linuxha/A1Video/README.md

# A1Video

An Apple I TTL updated video terminal section.

Modern TTL compatible Video Terminal for the Apple I reproduction boards
