linuxha/A1Video/docs/apple1-man-Pg14-video.pdf

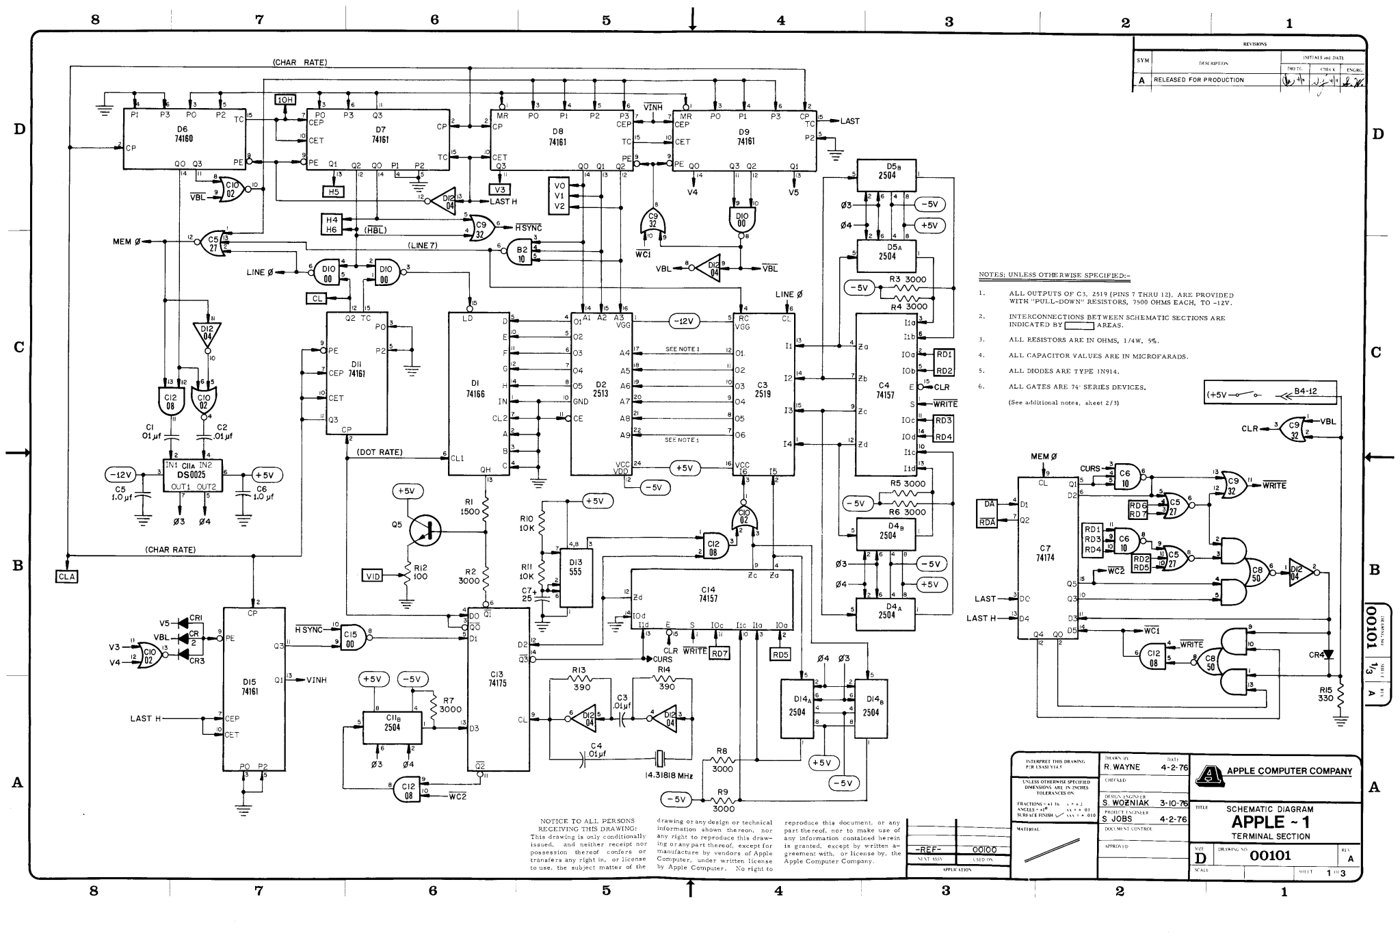
[picture p1: page 1]

8 | 7

(CHAR RATE)

6 | 5 | 4 | 3 | 2 | 1

SYM

IECKENGRE
RELEAS | RODUCTION
13 | 10H | 3 | VINH | 3
P1 | P2 | PO | P3 | Q3 | MR | PO | Pt | P2 | P3 | M | PO | P1 | P3 | CP | LAST D | D7 | D8 74160 | CET | 74161 | 74161 | 74161 | P2

CP
CET | PE PE Q1 | 02 20 P1 | EQO | Q3 Q2 | 2058
VBL | 02 | H5

H4
(HBL)
MEM | C513 | (LINE 7)

V3
LAST

4CS -HSYNC 32

WCI

VBL

V4 | V5
19 | 03- | -5V
1DIO | 04 | +5V

26
D5A 2504

VBL LINE Ø
00

CL

NOTES: | HERWIS R3 3000 -5V LINE Ø | ALL OUTPUTS OF C3, 2519 (PINS 7 THRU 12), ARE PROVIDED
4 | R3000
-12V | RC | 103 | ONS BETWEEN SCHEM

Iib
C | OPE

CEP 7411

13 | DI | D2
C12 | 02 CIO | CET | GN
IOd | RD1

RD2

C3 | CLR 74157

-WRIT

(DOT RATE) | CL
(-12V) | DS0025 | +5V
| ou
| | 1.0

(CHAR RATE)
B
CLA

A

2
CRI
H SYNC-VBL.

V4-

LAST H

ET

+5V
RI
1500
Q5 | RIO 10K

-5V

(+5V

B4-12

322

+5V | VCC

MEMØ
CURS

R5 3000
(-5V
R6 3000
RDA D4B 2504

WRITE

27

RD1

74174 03- -5V RDS

+5V
LASTDC
2504A | LAST H

054 2

WRITE RD7 | RD5 | Ø3

WC1
WRITE
CI2
RI2 | RII | D13
VID | 10K 3000
C7 | C14

DI5
74161
Q1 | VINH | +5V | (-5v | R13
74175 | 390 | 39

C3
3000
2504
03 | 04
C12 08 | -WC2
D14 | DI4
2504
+5V 3000 14.31818 MHz | (-5

R9

3000

conditionally
or

or any design or ther

this draw-
ot for | d, exc

Apple Computer Com

8 | 7
6 | 5 | | 4
-REF- | 00100

APPLICATION

3

D

50

CR4

### RIS

30

C

B00101 1/3 A

R.WAYNE | 4-2-7 | A APPLE COMPUTER COMPANY
CHES | A

010

S. WOZNIAK 3-10-7

PROIECT F

SCHEMATIC DIAGRAM

## APPLE~1

TERMINAL SECTION
D | 00101

2
