linuxha/A1Video/docs/a1video-schematic.png

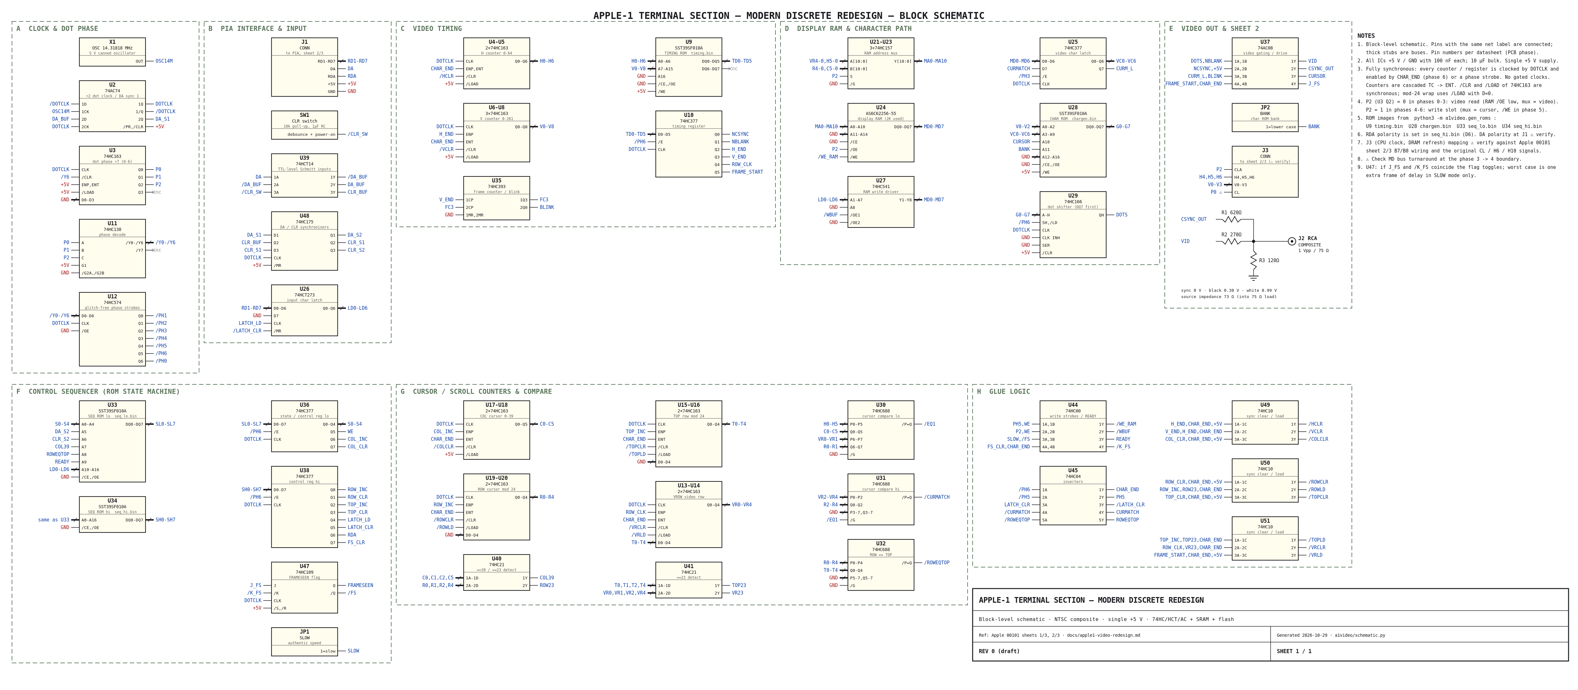
docs/a1video-schematic.png
