linuxha/A1Video/docs/schematic/a1video-sheet1.png

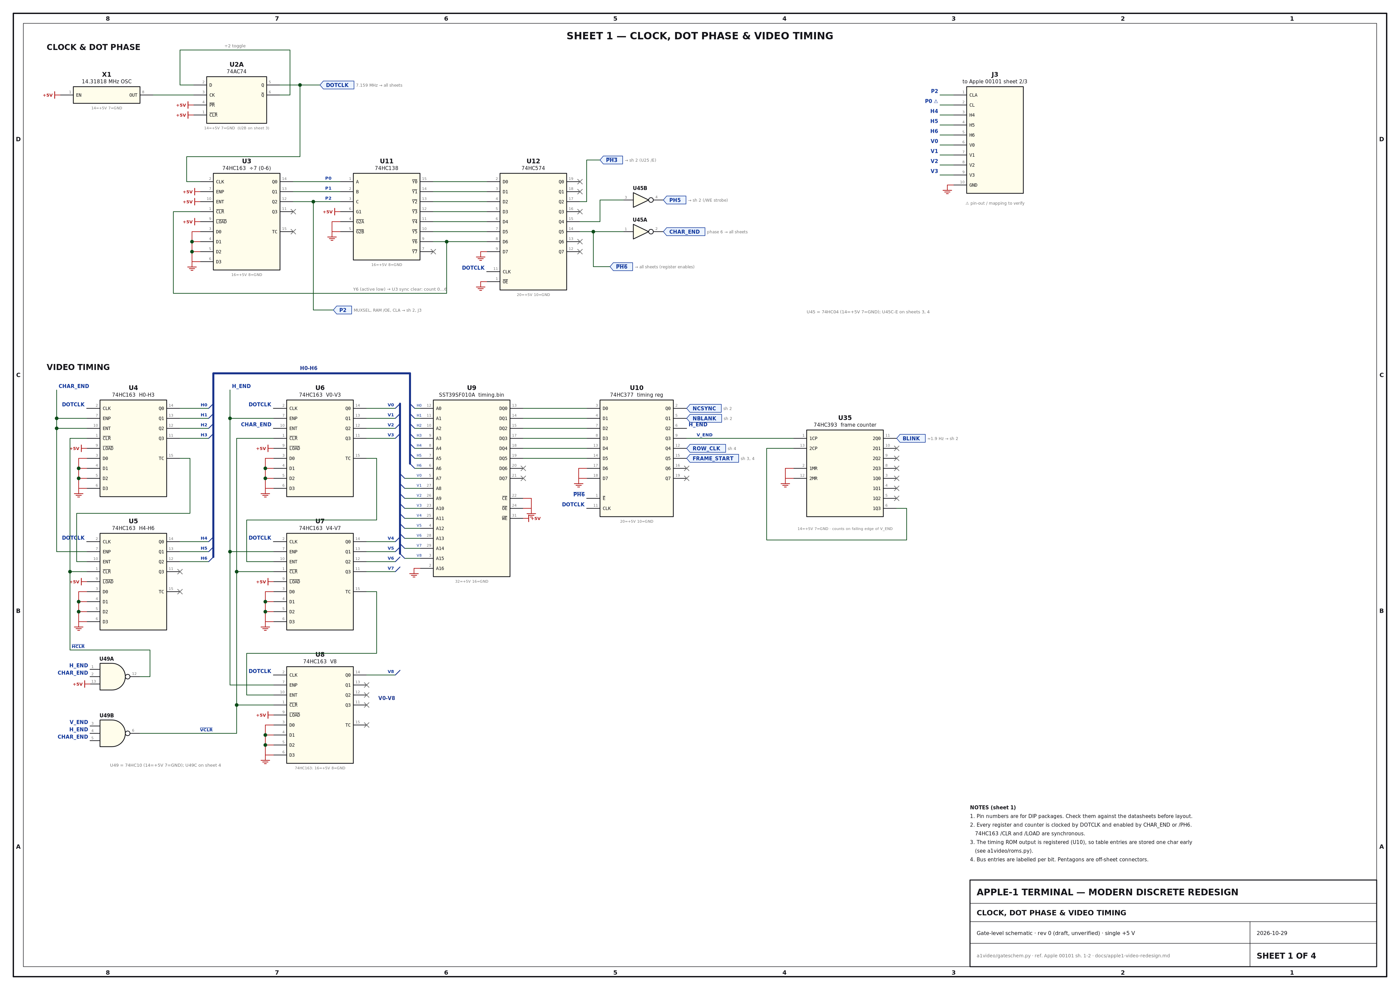
docs/schematic/a1video-sheet1.png
