linuxha/A1Video/docs/schematic/a1video-sheet2.png

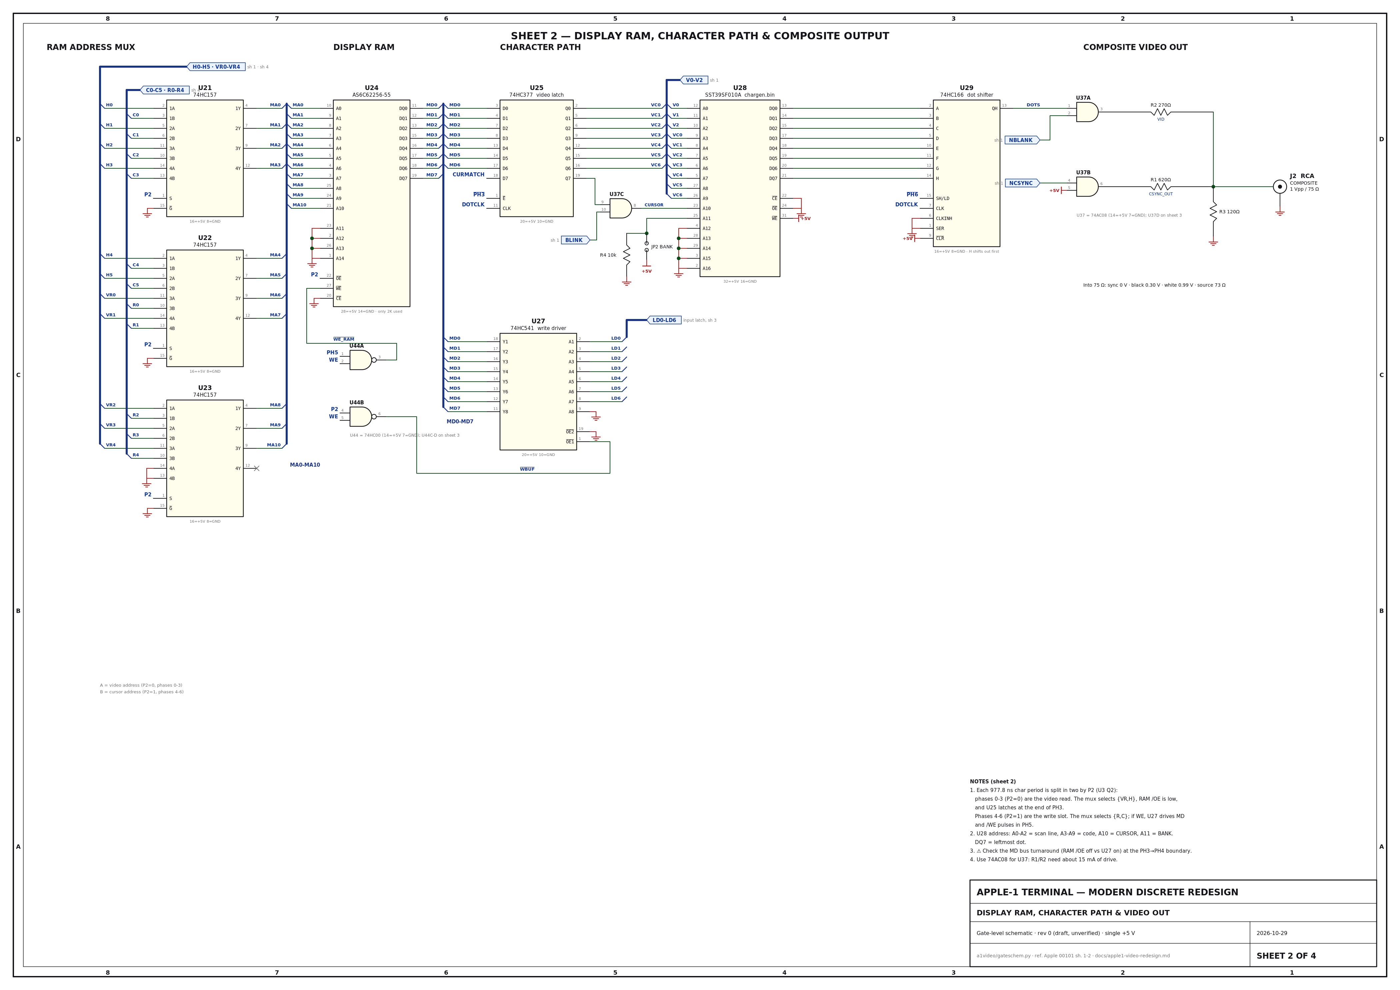
docs/schematic/a1video-sheet2.png
