linuxha/A1Video/docs/schematic/a1video-sheet3.png

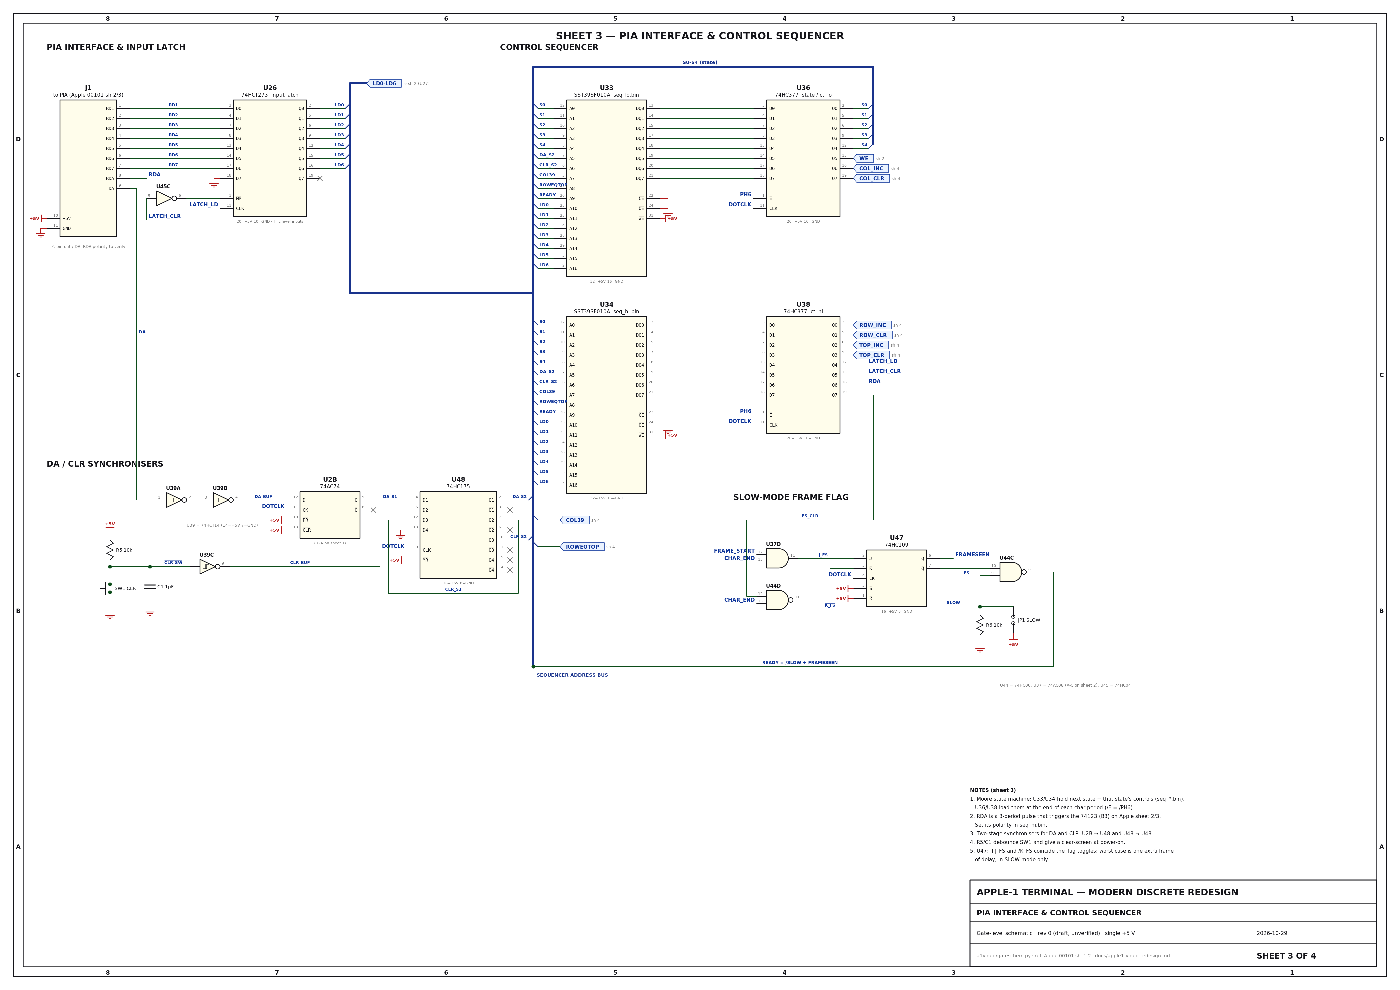
docs/schematic/a1video-sheet3.png
