linuxha/A1Video/docs/schematic/a1video-sheet4.png

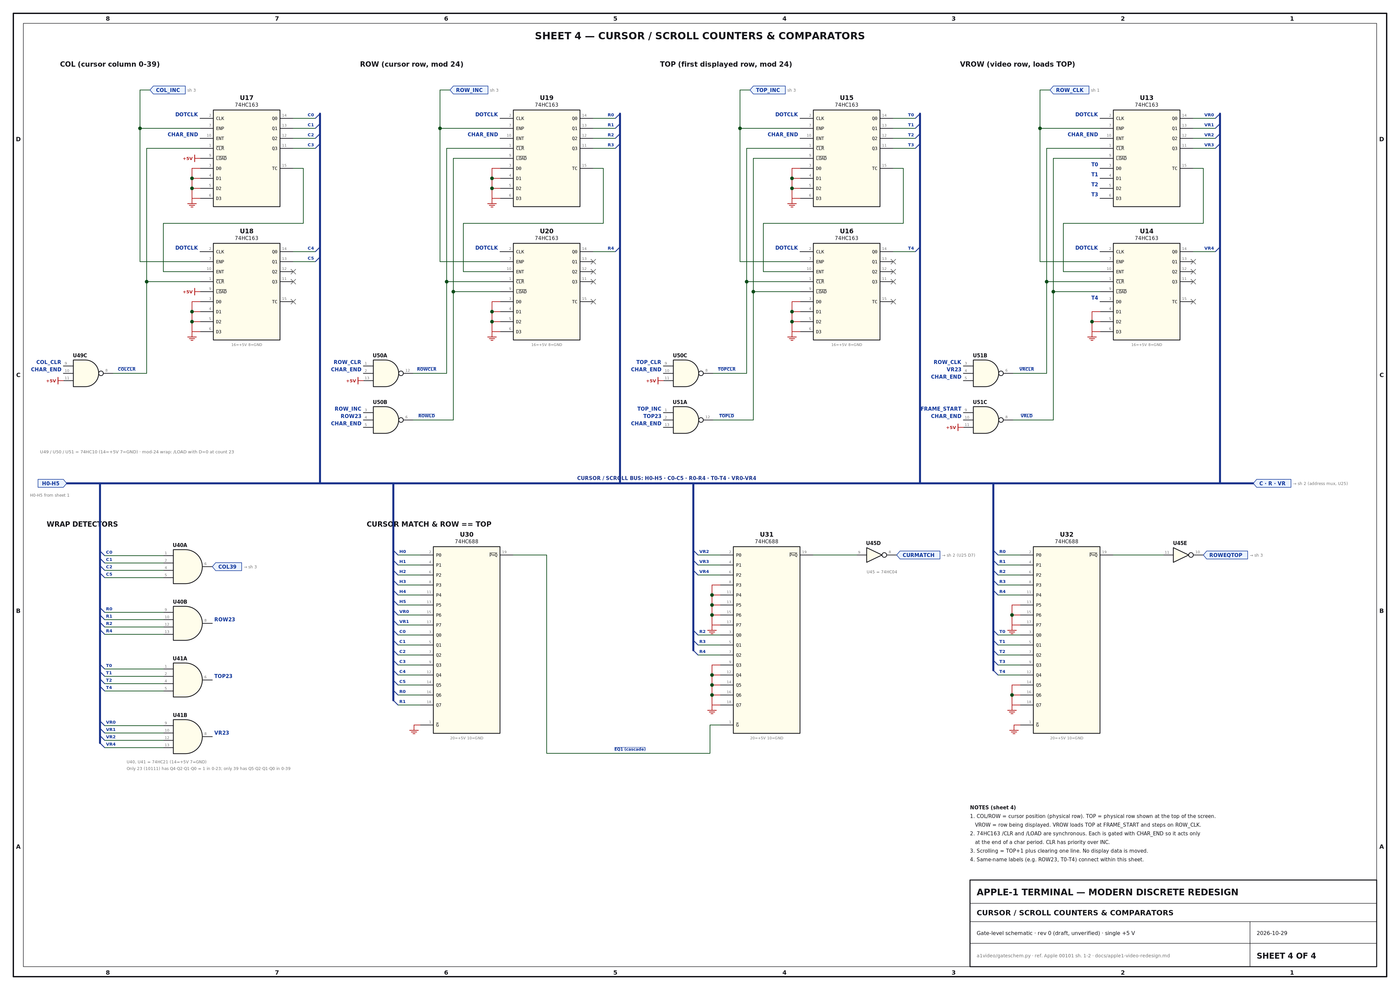
docs/schematic/a1video-sheet4.png
