linuxha/A1Video/kicad/counters.kicad_sch

## KiCad design kicad/counters.kicad_sch (2026-10-29)

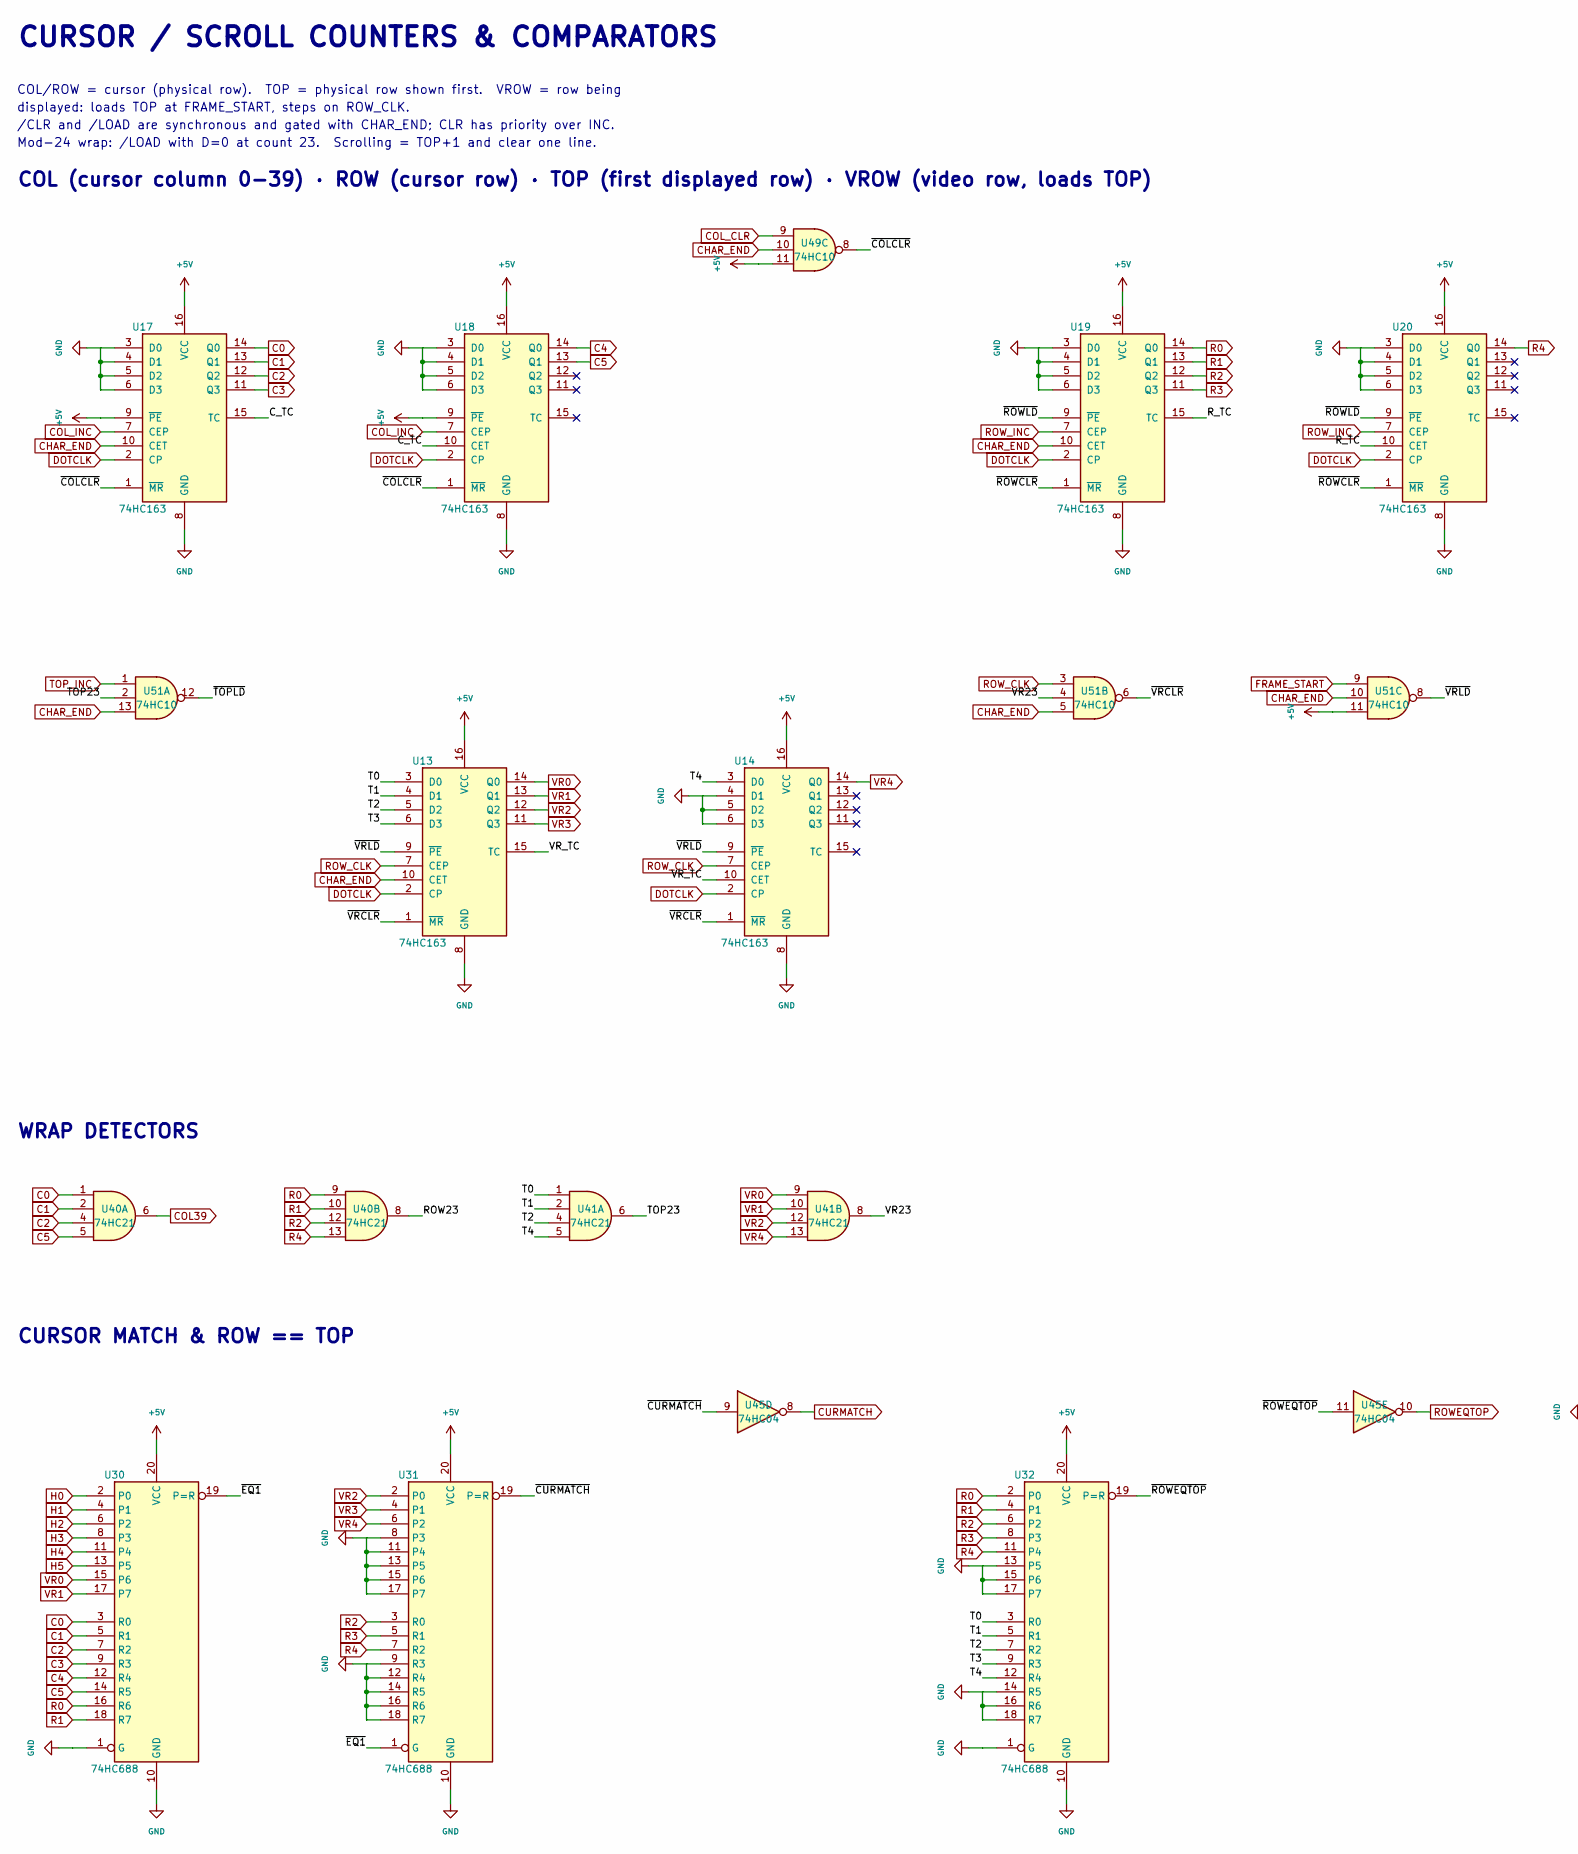
[picture p7: schematic counters.kicad_sch, part in row 1, column 1]

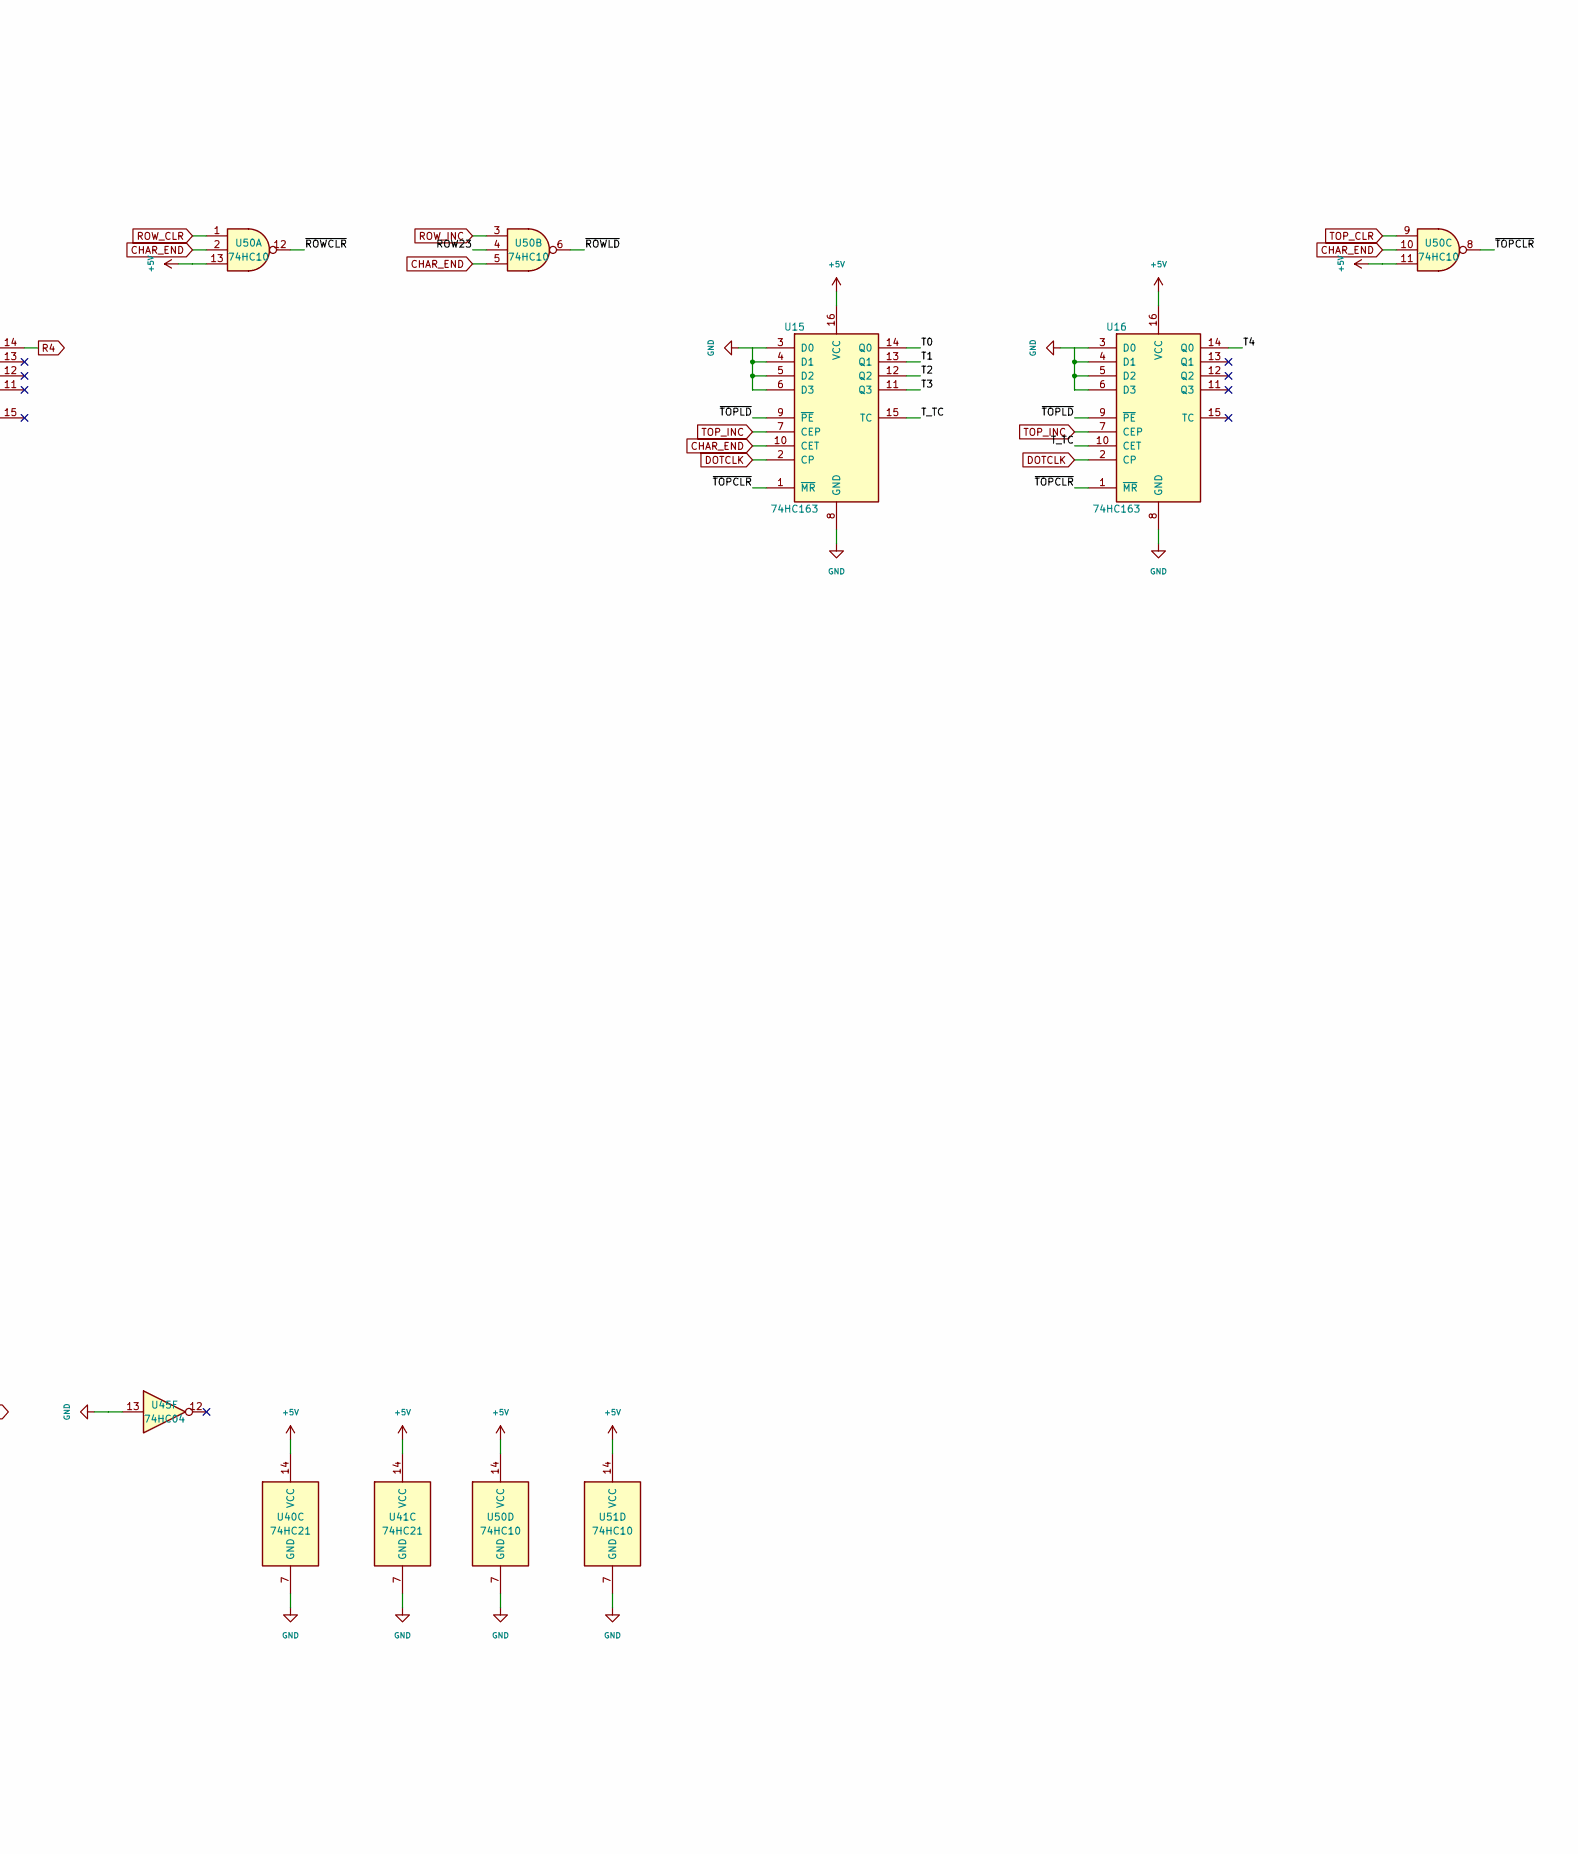
[picture p8: schematic counters.kicad_sch, part in row 1, column 2]

Parts:
U13, U14, U15, U16, U17, U18, U19, U20: 74HC163; DIP-16_W7.62mm
U30, U31, U32: 74HC688; DIP-20_W7.62mm
U40, U41: 74HC21; DIP-14_W7.62mm
U45: 74HC04; DIP-14_W7.62mm
U49, U50, U51: 74HC10; DIP-14_W7.62mm

Connections:
+5V: U13.16 (VCC), U14.16 (VCC), U15.16 (VCC), U16.16 (VCC), U17.9 (~PE), U17.16 (VCC), U18.9 (~PE), U18.16 (VCC), U19.16 (VCC), U20.16 (VCC), U30.20 (VCC), U31.20 (VCC), U32.20 (VCC), U40.14 (VCC), U41.14 (VCC), U49.11, U50.11, U50.13, U50.14 (VCC), U51.11, U51.14 (VCC)
C0: U17.14 (Q0), U30.3 (R0), U40.1
C1: U17.13 (Q1), U30.5 (R1), U40.2
C2: U17.12 (Q2), U30.7 (R2), U40.4
C3: U17.11 (Q3), U30.9 (R3)
C4: U18.14 (Q0), U30.12 (R4)
C5: U18.13 (Q1), U30.14 (R5), U40.5
CHAR_END: U13.10 (CET), U15.10 (CET), U17.10 (CET), U19.10 (CET), U49.10, U50.2, U50.5, U50.10, U51.5, U51.10, U51.13
COL39: U40.6
COL_CLR: U49.9
COL_INC: U17.7 (CEP), U18.7 (CEP)
CURMATCH: U45.8
C_TC: U17.15 (TC), U18.10 (CET)
DOTCLK: U13.2 (CP), U14.2 (CP), U15.2 (CP), U16.2 (CP), U17.2 (CP), U18.2 (CP), U19.2 (CP), U20.2 (CP)
FRAME_START: U51.9
GND: U13.8 (GND), U14.4 (D1), U14.5 (D2), U14.6 (D3), U14.8 (GND), U15.3 (D0), U15.4 (D1), U15.5 (D2), U15.6 (D3), U15.8 (GND), U16.3 (D0), U16.4 (D1), U16.5 (D2), U16.6 (D3), U16.8 (GND), U17.3 (D0), U17.4 (D1), U17.5 (D2), U17.6 (D3), U17.8 (GND), U18.3 (D0), U18.4 (D1), U18.5 (D2), U18.6 (D3), U18.8 (GND), U19.3 (D0), U19.4 (D1), U19.5 (D2), U19.6 (D3), U19.8 (GND), U20.3 (D0), U20.4 (D1), U20.5 (D2), U20.6 (D3), U20.8 (GND), U30.1 (G), U30.10 (GND), U31.8 (P3), U31.9 (R3), U31.10 (GND), U31.11 (P4), U31.12 (R4), U31.13 (P5), U31.14 (R5), U31.15 (P6), U31.16 (R6), U31.17 (P7), U31.18 (R7), U32.1 (G), U32.10 (GND), U32.13 (P5), U32.14 (R5), U32.15 (P6), U32.16 (R6), U32.17 (P7), U32.18 (R7), U40.7 (GND), U41.7 (GND), U45.13, U50.7 (GND), U51.7 (GND)
H0: U30.2 (P0)
H1: U30.4 (P1)
H2: U30.6 (P2)
H3: U30.8 (P3)
H4: U30.11 (P4)
H5: U30.13 (P5)
R0: U19.14 (Q0), U30.16 (R6), U32.2 (P0), U40.9
R1: U19.13 (Q1), U30.18 (R7), U32.4 (P1), U40.10
R2: U19.12 (Q2), U31.3 (R0), U32.6 (P2), U40.12
R3: U19.11 (Q3), U31.5 (R1), U32.8 (P3)
R4: U20.14 (Q0), U31.7 (R2), U32.11 (P4), U40.13
ROW23: U40.8, U50.4
ROWEQTOP: U45.10
ROW_CLK: U13.7 (CEP), U14.7 (CEP), U51.3
ROW_CLR: U50.1
ROW_INC: U19.7 (CEP), U20.7 (CEP), U50.3
R_TC: U19.15 (TC), U20.10 (CET)
T0: U13.3 (D0), U15.14 (Q0), U32.3 (R0), U41.1
T1: U13.4 (D1), U15.13 (Q1), U32.5 (R1), U41.2
T2: U13.5 (D2), U15.12 (Q2), U32.7 (R2), U41.4
T3: U13.6 (D3), U15.11 (Q3), U32.9 (R3)
T4: U14.3 (D0), U16.14 (Q0), U32.12 (R4), U41.5
TOP23: U41.6, U51.2
TOP_CLR: U50.9
TOP_INC: U15.7 (CEP), U16.7 (CEP), U51.1
T_TC: U15.15 (TC), U16.10 (CET)
VR0: U13.14 (Q0), U30.15 (P6), U41.9
VR1: U13.13 (Q1), U30.17 (P7), U41.10
VR2: U13.12 (Q2), U31.2 (P0), U41.12
VR3: U13.11 (Q3), U31.4 (P1)
VR4: U14.14 (Q0), U31.6 (P2), U41.13
VR23: U41.8, U51.4
VR_TC: U13.15 (TC), U14.10 (CET)
~COLCLR: U17.1 (~MR), U18.1 (~MR), U49.8
~CURMATCH: U31.19 (P=R), U45.9
~EQ1: U30.19 (P=R), U31.1 (G)
~ROWCLR: U19.1 (~MR), U20.1 (~MR), U50.12
~ROWEQTOP: U32.19 (P=R), U45.11
~ROWLD: U19.9 (~PE), U20.9 (~PE), U50.6
~TOPCLR: U15.1 (~MR), U16.1 (~MR), U50.8
~TOPLD: U15.9 (~PE), U16.9 (~PE), U51.12
~VRCLR: U13.1 (~MR), U14.1 (~MR), U51.6
~VRLD: U13.9 (~PE), U14.9 (~PE), U51.8

Notes on the sheet:
CURSOR / SCROLL COUNTERS & COMPARATORS
COL/ROW = cursor (physical row). TOP = physical row shown first. VROW = row being
displayed: loads TOP at FRAME_START, steps on ROW_CLK.
/CLR and /LOAD are synchronous and gated with CHAR_END; CLR has priority over INC.
Mod-24 wrap: /LOAD with D=0 at count 23. Scrolling = TOP+1 and clear one line.
COL (cursor column 0-39) · ROW (cursor row) · TOP (first displayed row) · VROW (video row, loads TOP)
WRAP DETECTORS
CURSOR MATCH & ROW == TOP
