linuxha/A1Video/kicad/power.kicad_sch

## KiCad design kicad/power.kicad_sch (2026-10-29)

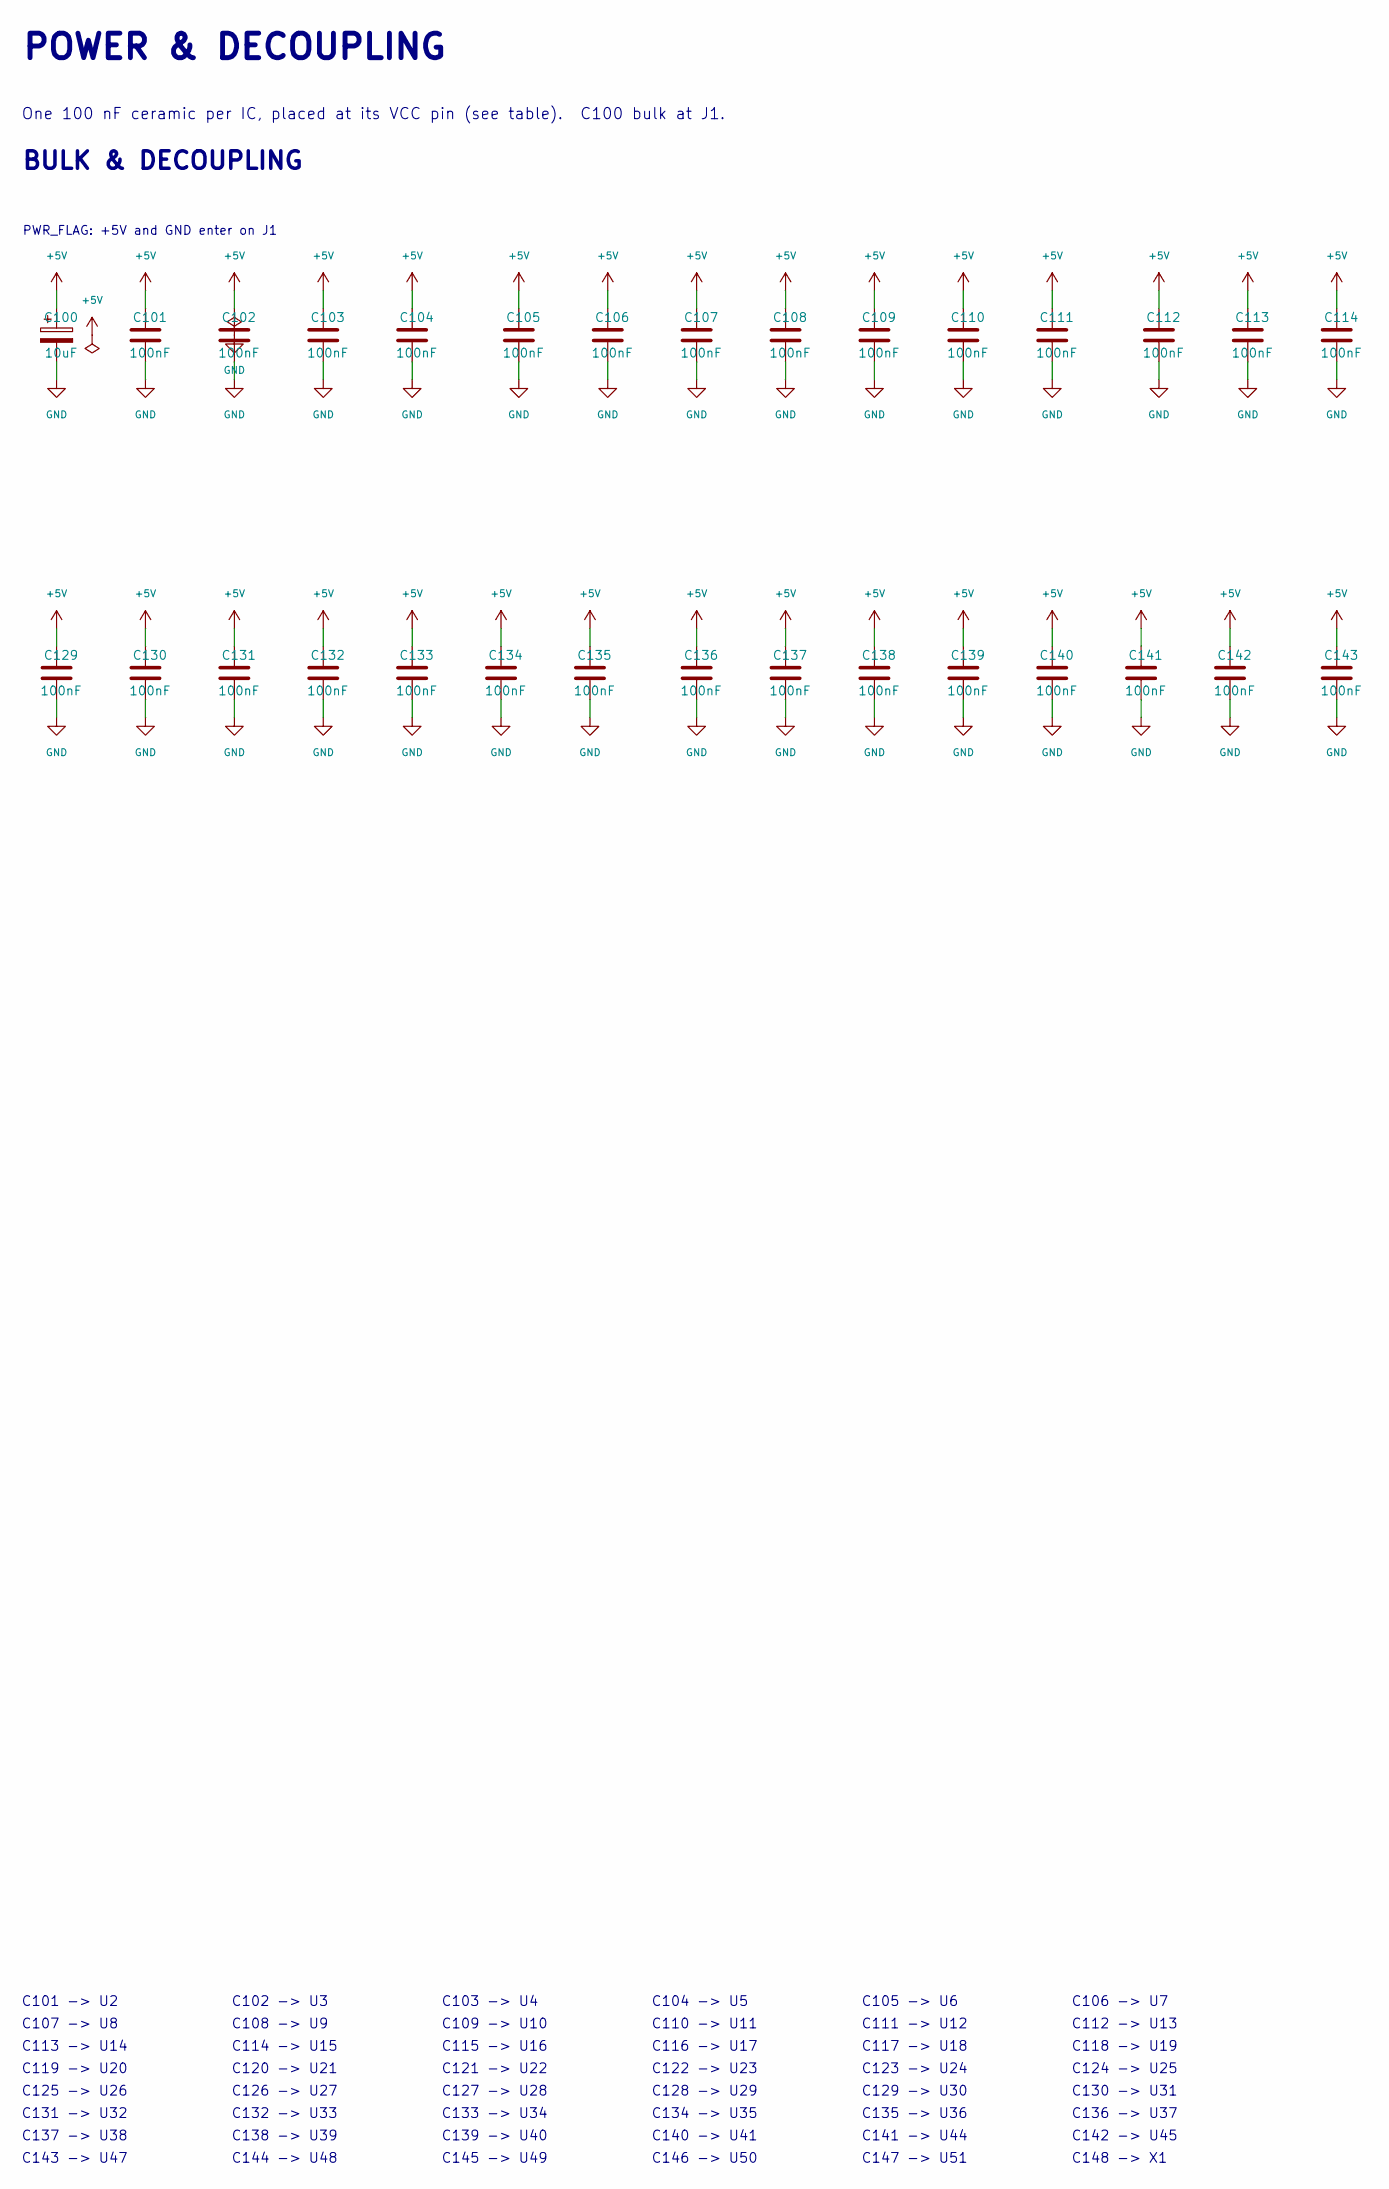
[picture p9: schematic power.kicad_sch, part in row 1, column 1]

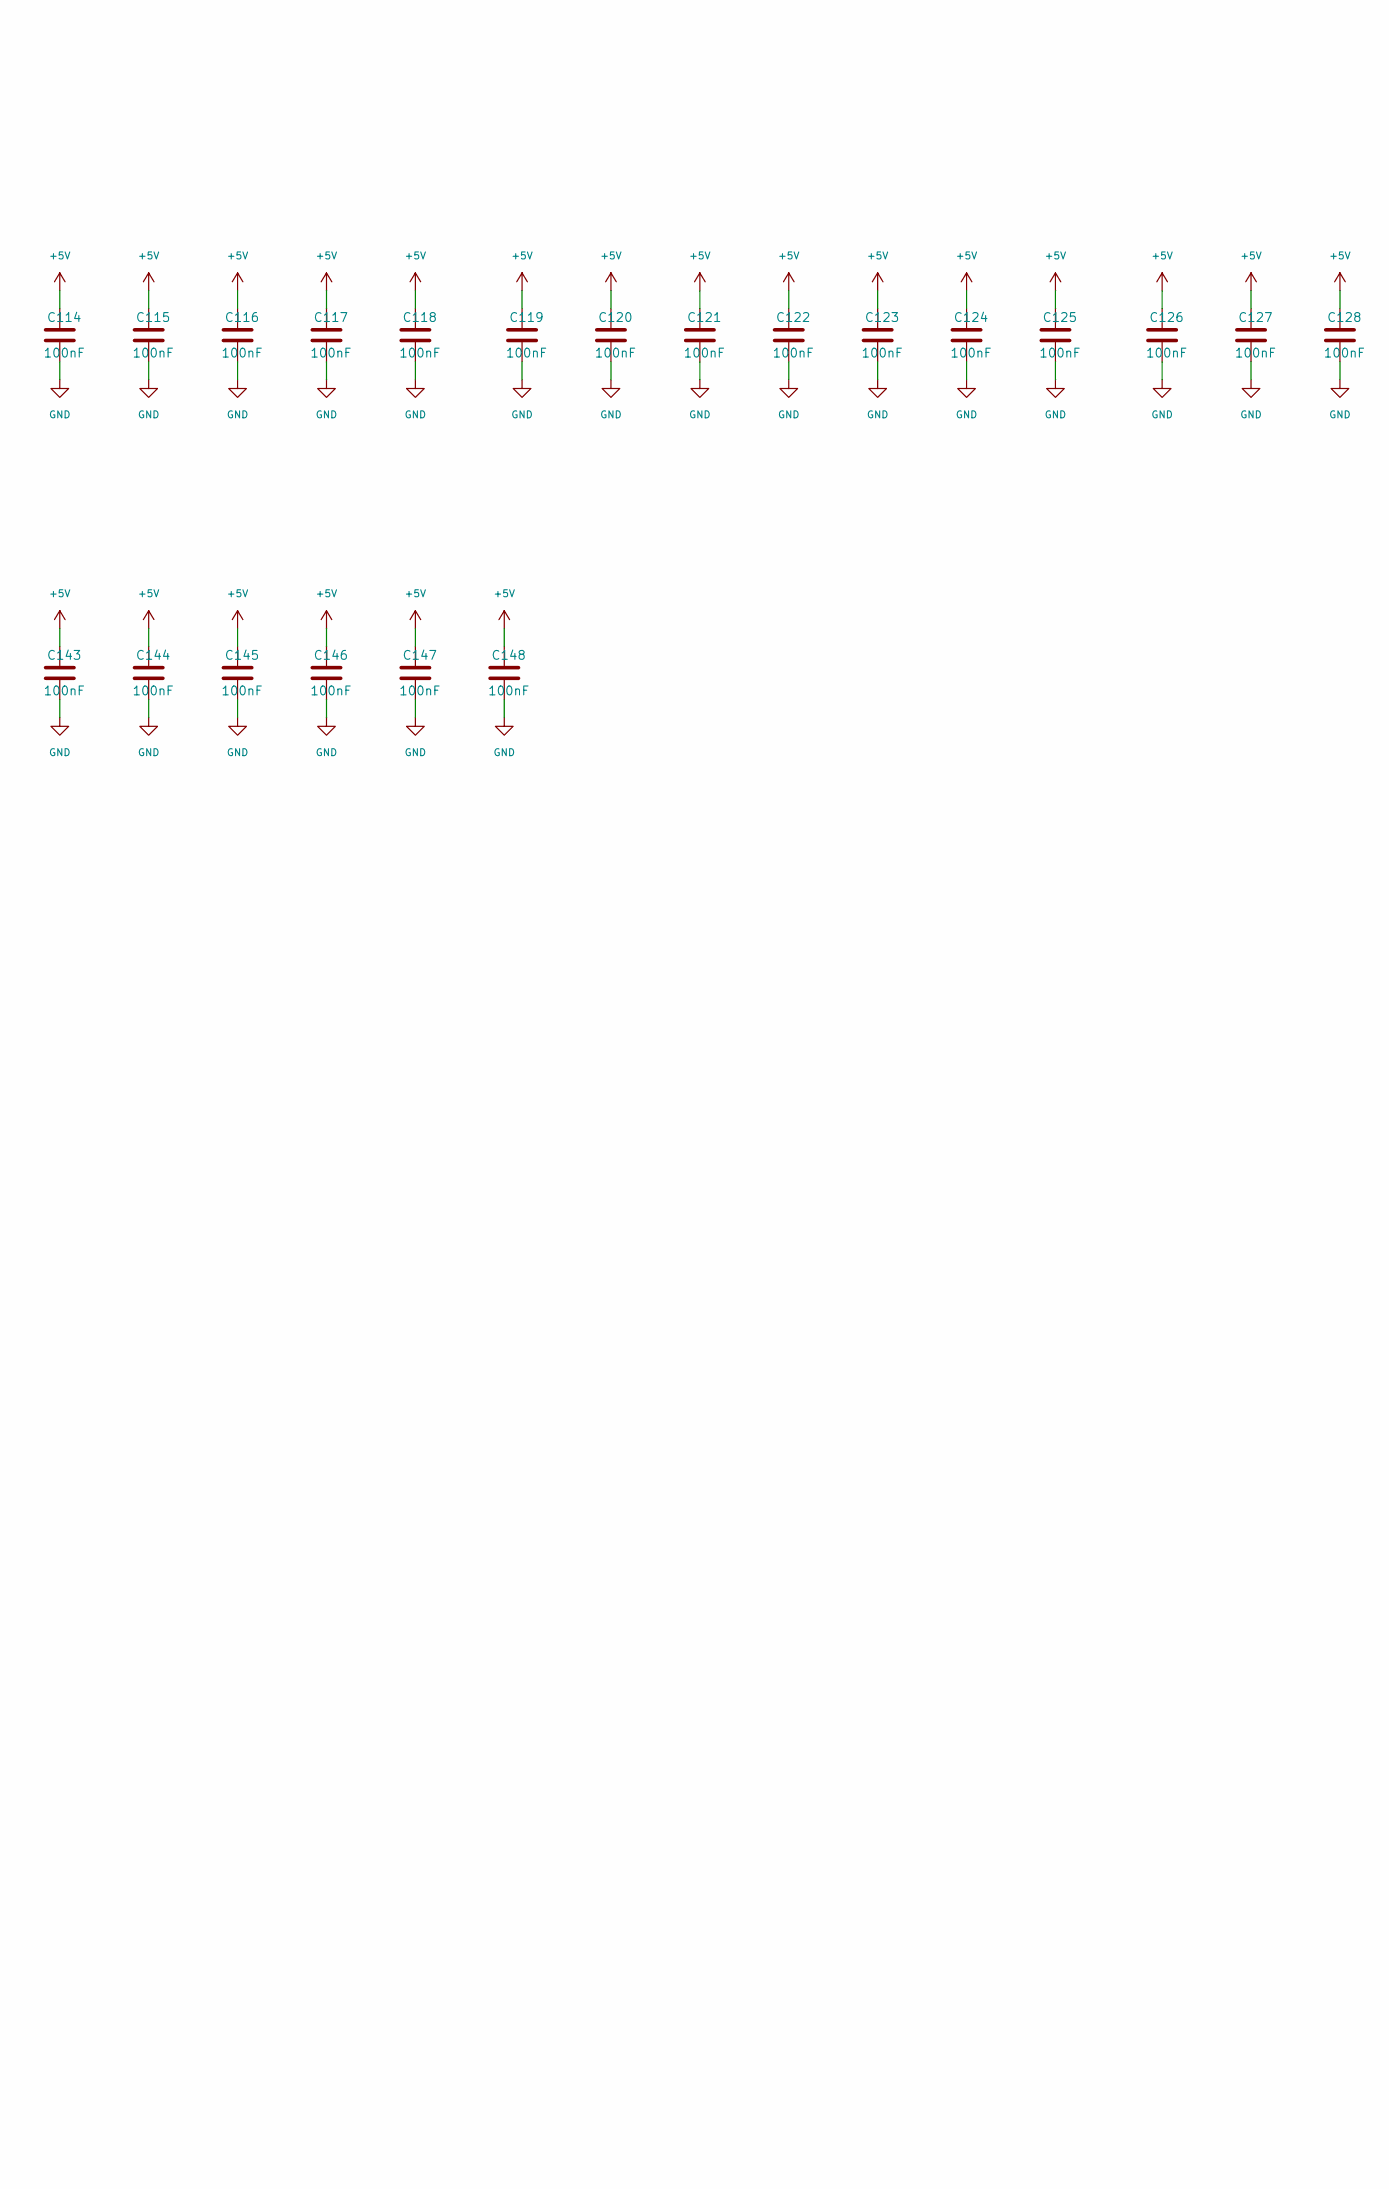
[picture p10: schematic power.kicad_sch, part in row 1, column 2]

Parts:
C100: 10uF; CP_Radial_D5.0mm_P2.00mm
C101, C102, C103, C104, C105, C106, C107, C108, C109, C110, C111, C112, C113, C114, C115, C116, C117, C118, C119, C120, C121, C122, C123, C124, C125, C126, C127, C128, C129, C130, C131, C132, C133, C134, C135, C136, C137, C138, C139, C140, C141, C142, C143, C144, C145, C146, C147, C148: 100nF; C_Disc_D5.0mm_W2.5mm_P5.00mm

Connections:
+5V: C100.1, C101.1, C102.1, C103.1, C104.1, C105.1, C106.1, C107.1, C108.1, C109.1, C110.1, C111.1, C112.1, C113.1, C114.1, C115.1, C116.1, C117.1, C118.1, C119.1, C120.1, C121.1, C122.1, C123.1, C124.1, C125.1, C126.1, C127.1, C128.1, C129.1, C130.1, C131.1, C132.1, C133.1, C134.1, C135.1, C136.1, C137.1, C138.1, C139.1, C140.1, C141.1, C142.1, C143.1, C144.1, C145.1, C146.1, C147.1, C148.1
GND: C100.2, C101.2, C102.2, C103.2, C104.2, C105.2, C106.2, C107.2, C108.2, C109.2, C110.2, C111.2, C112.2, C113.2, C114.2, C115.2, C116.2, C117.2, C118.2, C119.2, C120.2, C121.2, C122.2, C123.2, C124.2, C125.2, C126.2, C127.2, C128.2, C129.2, C130.2, C131.2, C132.2, C133.2, C134.2, C135.2, C136.2, C137.2, C138.2, C139.2, C140.2, C141.2, C142.2, C143.2, C144.2, C145.2, C146.2, C147.2, C148.2

Notes on the sheet:
POWER & DECOUPLING
One 100 nF ceramic per IC, placed at its VCC pin (see table). C100 bulk at J1.
BULK & DECOUPLING
PWR_FLAG: +5V and GND enter on J1
C101 -> U2
C102 -> U3
C103 -> U4
C104 -> U5
C105 -> U6
C106 -> U7
C107 -> U8
C108 -> U9
C109 -> U10
C110 -> U11
C111 -> U12
C112 -> U13
C113 -> U14
C114 -> U15
C115 -> U16
C116 -> U17
C117 -> U18
C118 -> U19
C119 -> U20
C120 -> U21
C121 -> U22
C122 -> U23
C123 -> U24
C124 -> U25
C125 -> U26
C126 -> U27
C127 -> U28
C128 -> U29
C129 -> U30
C130 -> U31
C131 -> U32
C132 -> U33
C133 -> U34
C134 -> U35
C135 -> U36
C136 -> U37
C137 -> U38
C138 -> U39
C139 -> U40
C140 -> U41
C141 -> U44
C142 -> U45
C143 -> U47
C144 -> U48
C145 -> U49
C146 -> U50
C147 -> U51
C148 -> X1
