linuxha/A1Video/kicad/sequencer.kicad_sch

## KiCad design kicad/sequencer.kicad_sch (2026-10-29)

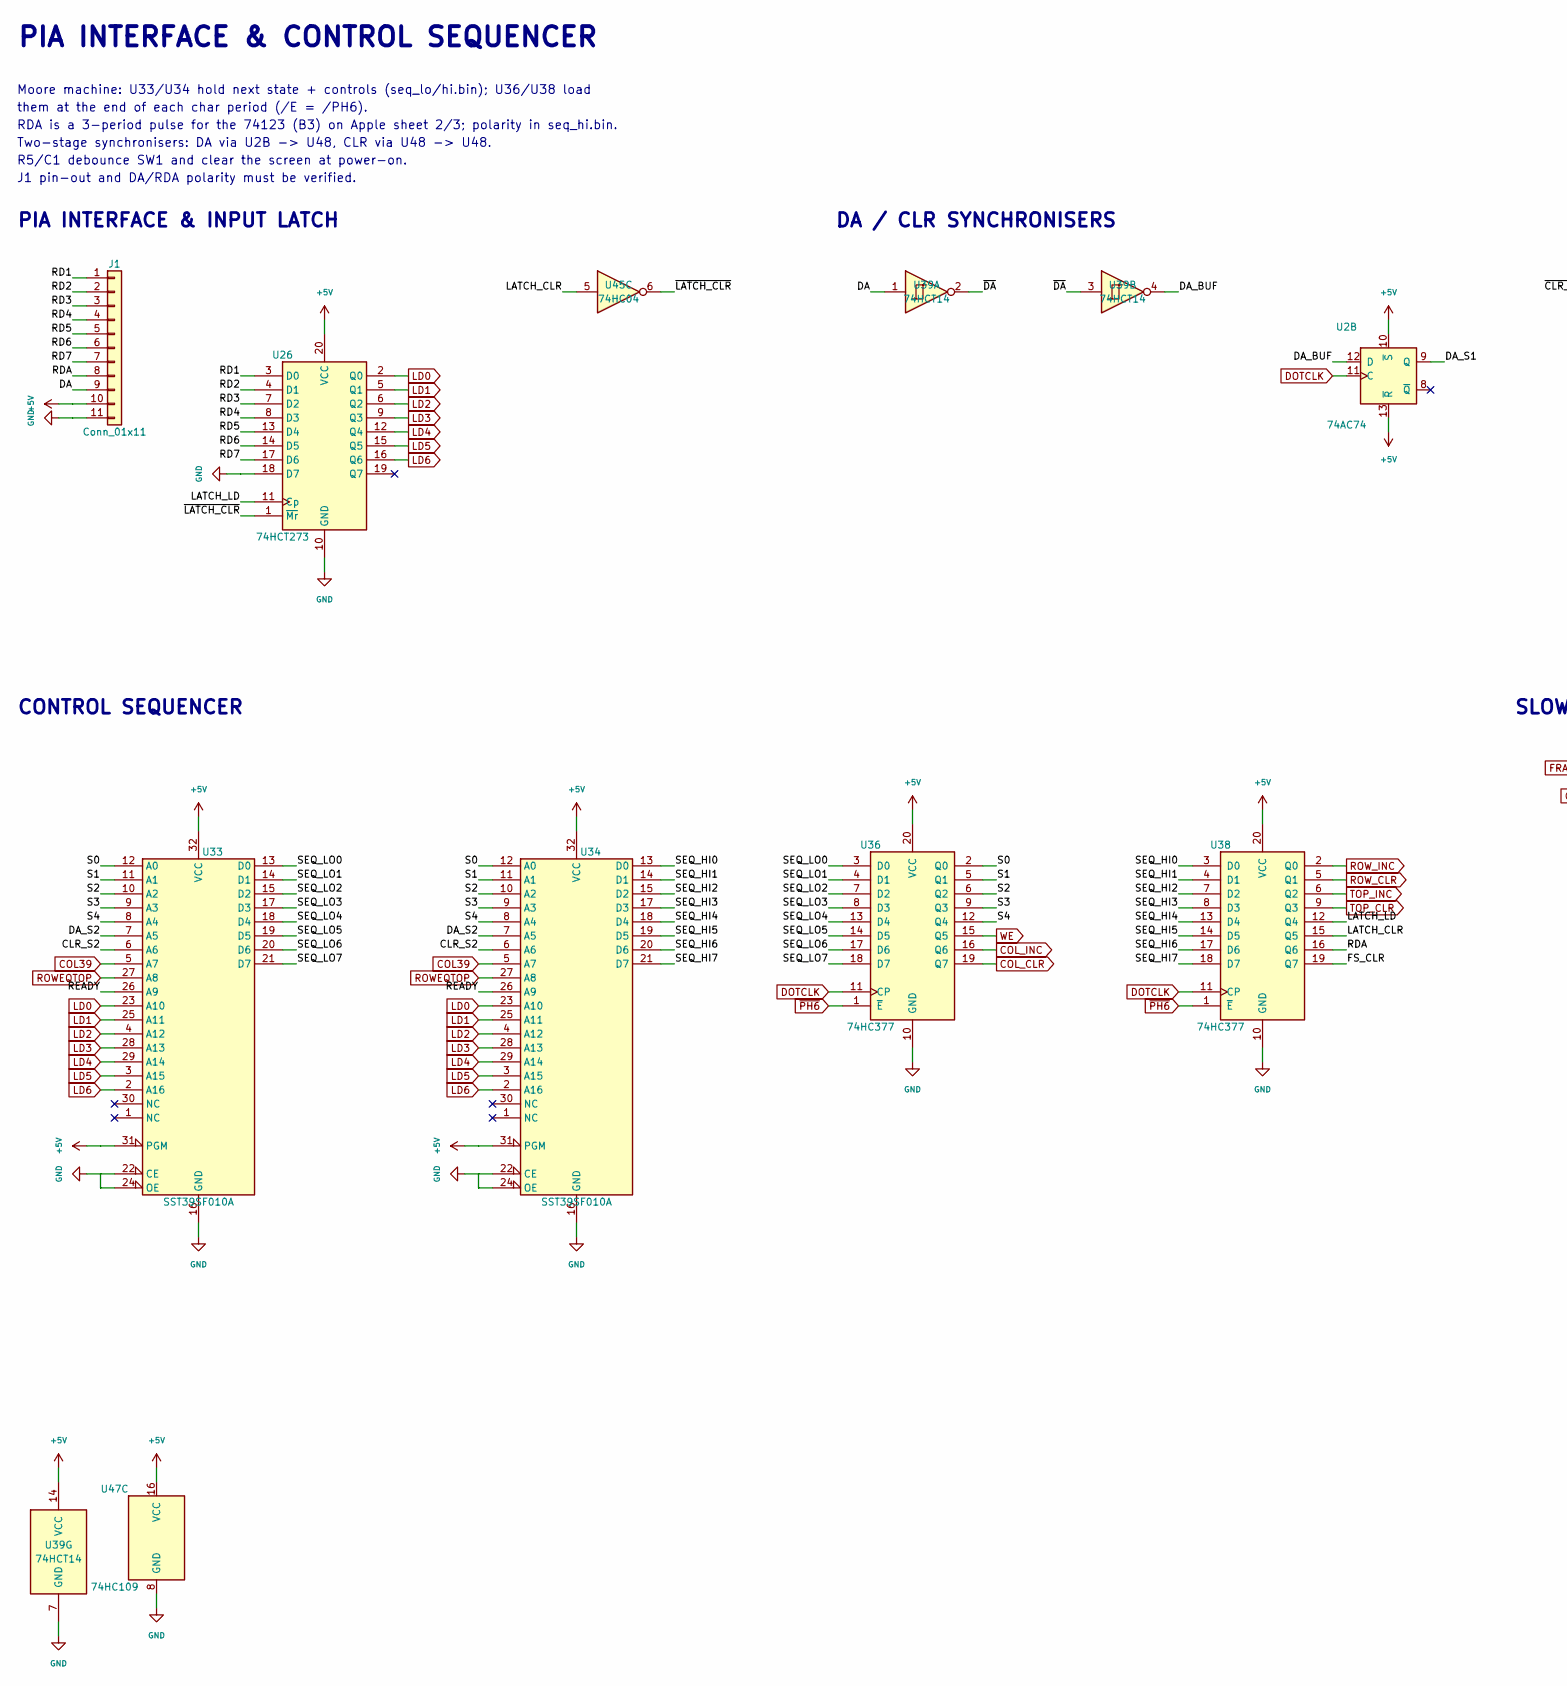
[picture p11: schematic sequencer.kicad_sch, part in row 1, column 1]

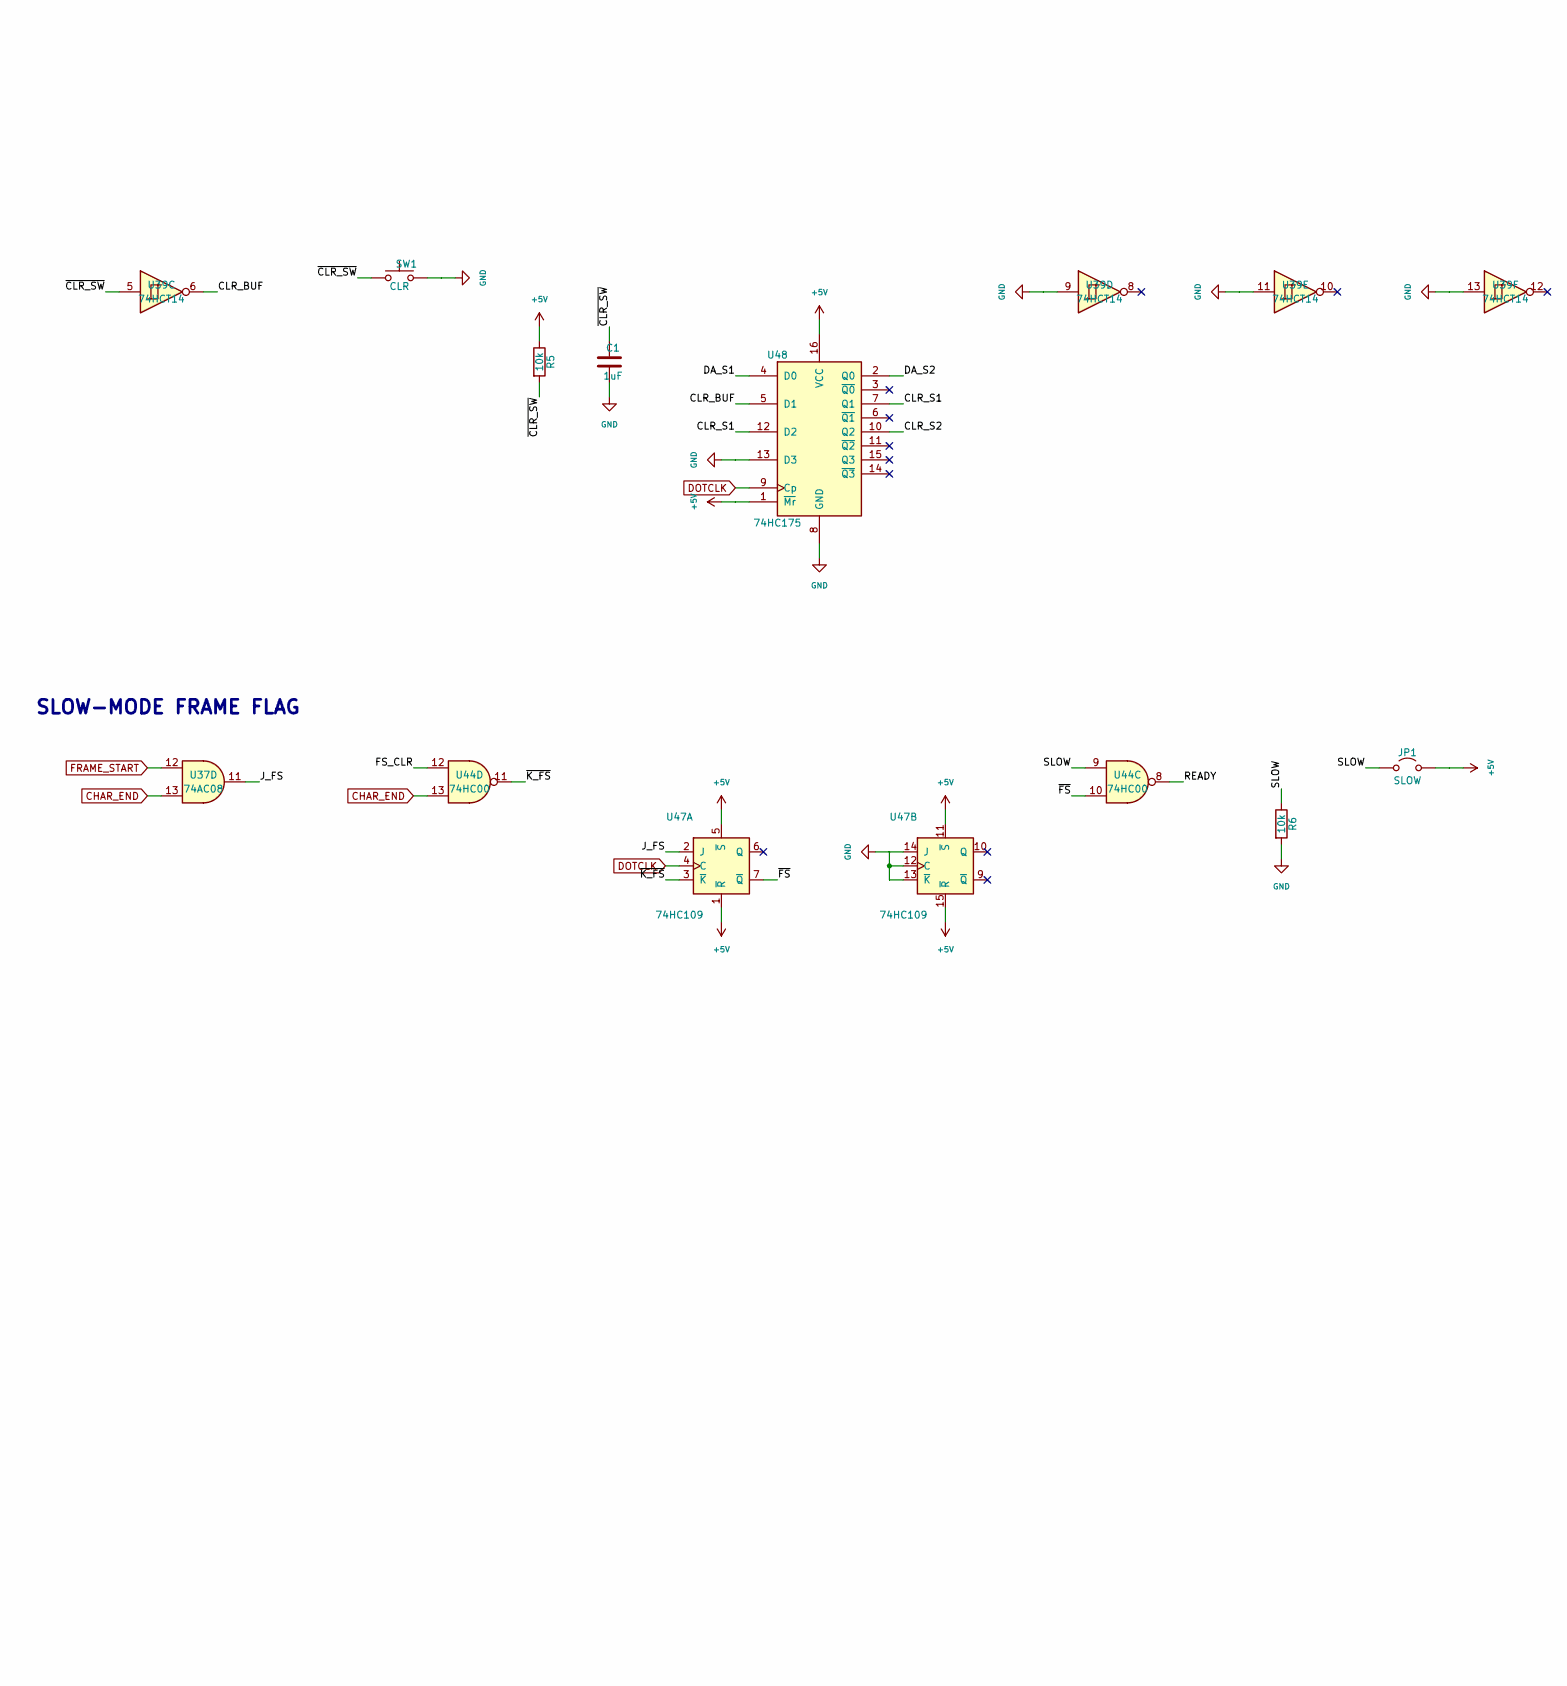
[picture p12: schematic sequencer.kicad_sch, part in row 1, column 2]

Parts:
C1: 1uF; C_Disc_D5.0mm_W2.5mm_P5.00mm
J1: Conn_01x11; PinHeader_1x11_P2.54mm_Vertical
JP1: SLOW; PinHeader_1x02_P2.54mm_Vertical
R5, R6: 10k; R_Axial_DIN0207_L6.3mm_D2.5mm_P10.16mm_Horizontal
SW1: CLR; SW_PUSH_6mm
U2: 74AC74; DIP-14_W7.62mm
U26: 74HCT273; DIP-20_W7.62mm
U33, U34: SST39SF010A; DIP-32_W15.24mm
U36, U38: 74HC377; DIP-20_W7.62mm
U37: 74AC08; DIP-14_W7.62mm
U39: 74HCT14; DIP-14_W7.62mm
U44: 74HC00; DIP-14_W7.62mm
U45: 74HC04; DIP-14_W7.62mm
U47: 74HC109; DIP-16_W7.62mm
U48: 74HC175; DIP-16_W7.62mm

Connections:
+5V: J1.10, JP1.2 (B), R5.1, U2.10 (~S), U2.13 (~R), U26.20 (VCC), U33.31 (PGM), U33.32 (VCC), U34.31 (PGM), U34.32 (VCC), U36.20 (VCC), U38.20 (VCC), U39.14 (VCC), U47.1 (~R), U47.5 (~S), U47.11 (~S), U47.15 (~R), U47.16 (VCC), U48.1 (~Mr), U48.16 (VCC)
CHAR_END: U37.13, U44.13
CLR_BUF: U39.6, U48.5 (D1)
CLR_S1: U48.7 (Q1), U48.12 (D2)
CLR_S2: U33.6 (A6), U34.6 (A6), U48.10 (Q2)
COL39: U33.5 (A7), U34.5 (A7)
COL_CLR: U36.19 (Q7)
COL_INC: U36.16 (Q6)
DA: J1.9, U39.1
DA_BUF: U2.12 (D), U39.4
DA_S1: U2.9 (Q), U48.4 (D0)
DA_S2: U33.7 (A5), U34.7 (A5), U48.2 (Q0)
DOTCLK: U2.11 (C), U36.11 (CP), U38.11 (CP), U47.4 (C), U48.9 (Cp)
FRAME_START: U37.12
FS_CLR: U38.19 (Q7), U44.12
GND: C1.2, J1.11, R6.2, SW1.2, U26.10 (GND), U26.18 (D7), U33.16 (GND), U33.22 (CE), U33.24 (OE), U34.16 (GND), U34.22 (CE), U34.24 (OE), U36.10 (GND), U38.10 (GND), U39.7 (GND), U39.9, U39.11, U39.13, U47.8 (GND), U47.12 (C), U47.13 (~K), U47.14 (J), U48.8 (GND), U48.13 (D3)
J_FS: U37.11, U47.2 (J)
LATCH_CLR: U38.15 (Q5), U45.5
LATCH_LD: U26.11 (Cp), U38.12 (Q4)
LD0: U26.2 (Q0), U33.23 (A10), U34.23 (A10)
LD1: U26.5 (Q1), U33.25 (A11), U34.25 (A11)
LD2: U26.6 (Q2), U33.4 (A12), U34.4 (A12)
LD3: U26.9 (Q3), U33.28 (A13), U34.28 (A13)
LD4: U26.12 (Q4), U33.29 (A14), U34.29 (A14)
LD5: U26.15 (Q5), U33.3 (A15), U34.3 (A15)
LD6: U26.16 (Q6), U33.2 (A16), U34.2 (A16)
RD1: J1.1, U26.3 (D0)
RD2: J1.2, U26.4 (D1)
RD3: J1.3, U26.7 (D2)
RD4: J1.4, U26.8 (D3)
RD5: J1.5, U26.13 (D4)
RD6: J1.6, U26.14 (D5)
RD7: J1.7, U26.17 (D6)
RDA: J1.8, U38.16 (Q6)
READY: U33.26 (A9), U34.26 (A9), U44.8
ROWEQTOP: U33.27 (A8), U34.27 (A8)
ROW_CLR: U38.5 (Q1)
ROW_INC: U38.2 (Q0)
S0: U33.12 (A0), U34.12 (A0), U36.2 (Q0)
S1: U33.11 (A1), U34.11 (A1), U36.5 (Q1)
S2: U33.10 (A2), U34.10 (A2), U36.6 (Q2)
S3: U33.9 (A3), U34.9 (A3), U36.9 (Q3)
S4: U33.8 (A4), U34.8 (A4), U36.12 (Q4)
SEQ_HI0: U34.13 (D0), U38.3 (D0)
SEQ_HI1: U34.14 (D1), U38.4 (D1)
SEQ_HI2: U34.15 (D2), U38.7 (D2)
SEQ_HI3: U34.17 (D3), U38.8 (D3)
SEQ_HI4: U34.18 (D4), U38.13 (D4)
SEQ_HI5: U34.19 (D5), U38.14 (D5)
SEQ_HI6: U34.20 (D6), U38.17 (D6)
SEQ_HI7: U34.21 (D7), U38.18 (D7)
SEQ_LO0: U33.13 (D0), U36.3 (D0)
SEQ_LO1: U33.14 (D1), U36.4 (D1)
SEQ_LO2: U33.15 (D2), U36.7 (D2)
SEQ_LO3: U33.17 (D3), U36.8 (D3)
SEQ_LO4: U33.18 (D4), U36.13 (D4)
SEQ_LO5: U33.19 (D5), U36.14 (D5)
SEQ_LO6: U33.20 (D6), U36.17 (D6)
SEQ_LO7: U33.21 (D7), U36.18 (D7)
SLOW: JP1.1 (A), R6.1, U44.9
TOP_CLR: U38.9 (Q3)
TOP_INC: U38.6 (Q2)
WE: U36.15 (Q5)
~CLR_SW: C1.1, R5.2, SW1.1, U39.5
~DA: U39.2, U39.3
~FS: U44.10, U47.7 (~Q)
~K_FS: U44.11, U47.3 (~K)
~LATCH_CLR: U26.1 (~Mr), U45.6
~PH6: U36.1 (~E), U38.1 (~E)

Notes on the sheet:
PIA INTERFACE & CONTROL SEQUENCER
Moore machine: U33/U34 hold next state + controls (seq_lo/hi.bin); U36/U38 load
them at the end of each char period (/E = /PH6).
RDA is a 3-period pulse for the 74123 (B3) on Apple sheet 2/3; polarity in seq_hi.bin.
Two-stage synchronisers: DA via U2B -> U48, CLR via U48 -> U48.
R5/C1 debounce SW1 and clear the screen at power-on.
J1 pin-out and DA/RDA polarity must be verified.
PIA INTERFACE & INPUT LATCH
DA / CLR SYNCHRONISERS
CONTROL SEQUENCER
SLOW-MODE FRAME FLAG
