linuxha/A1Video/kicad/timing.kicad_sch

## KiCad design kicad/timing.kicad_sch (2026-10-29)

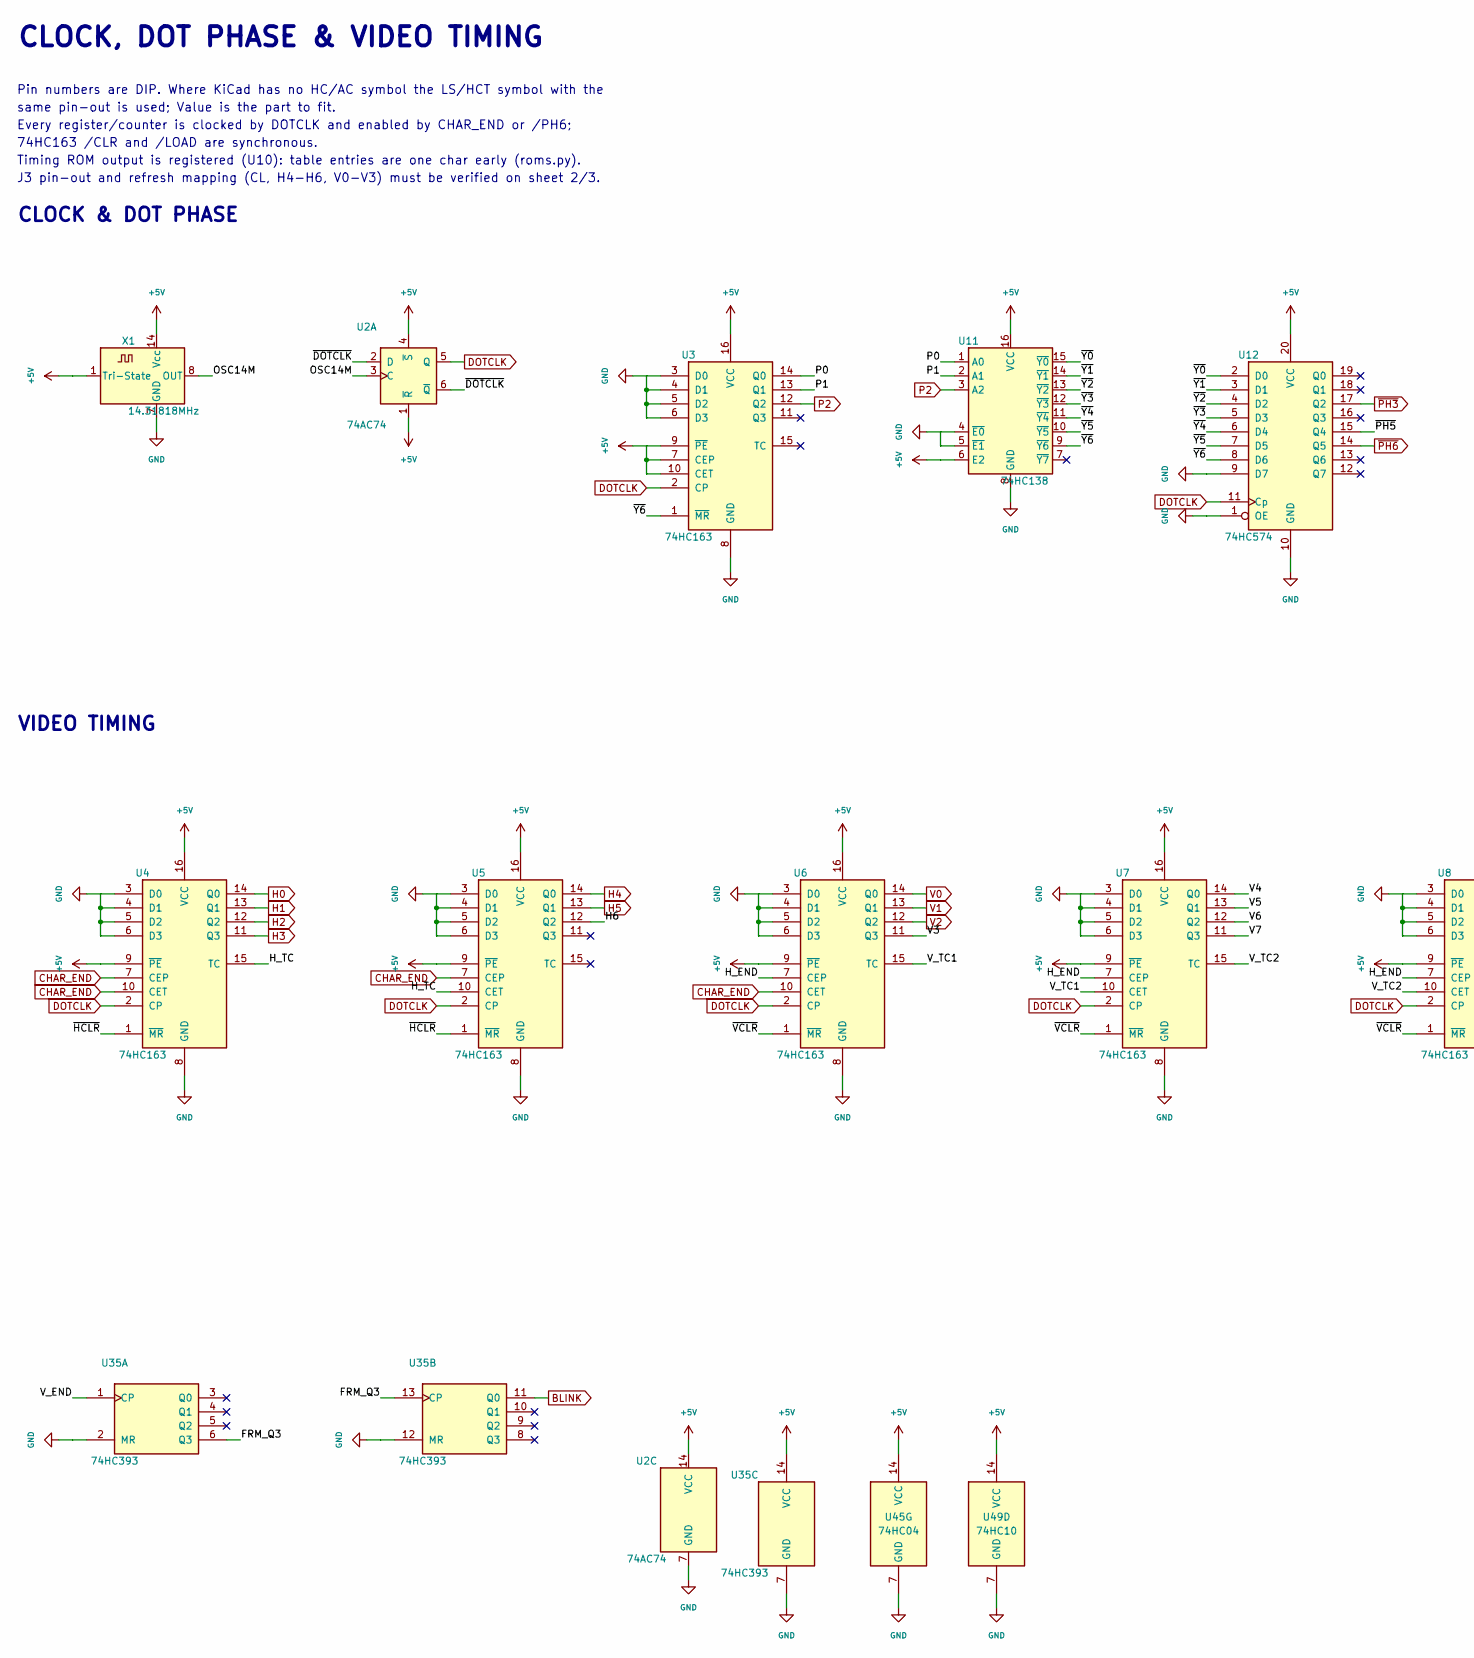
[picture p13: schematic timing.kicad_sch, part in row 1, column 1]

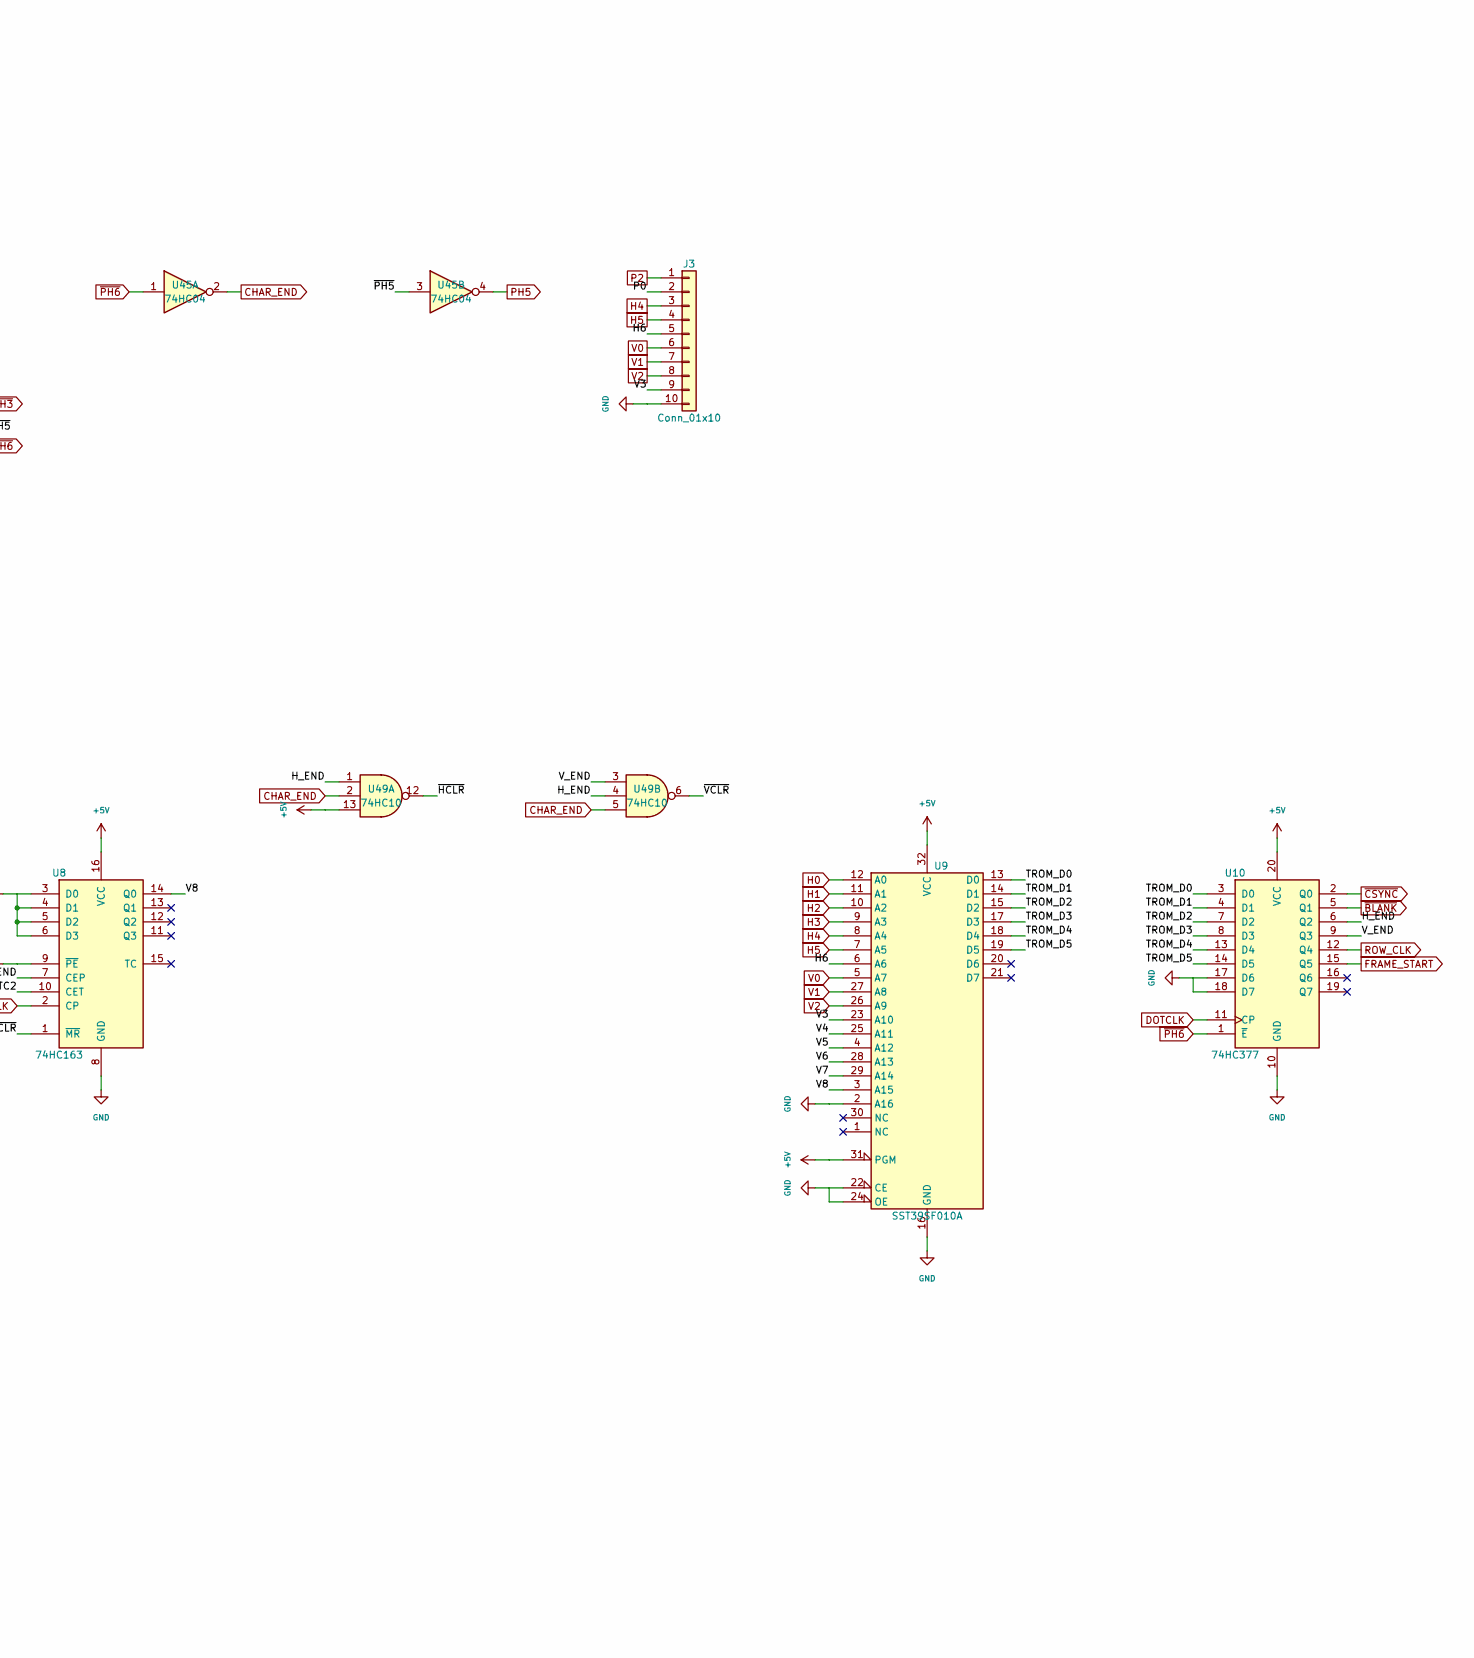
[picture p14: schematic timing.kicad_sch, part in row 1, column 2]

Parts:
J3: Conn_01x10; PinHeader_1x10_P2.54mm_Vertical
U2: 74AC74; DIP-14_W7.62mm
U3, U4, U5, U6, U7, U8: 74HC163; DIP-16_W7.62mm
U9: SST39SF010A; DIP-32_W15.24mm
U10: 74HC377; DIP-20_W7.62mm
U11: 74HC138; DIP-16_W7.62mm
U12: 74HC574; DIP-20_W7.62mm
U35: 74HC393; DIP-14_W7.62mm
U45: 74HC04; DIP-14_W7.62mm
U49: 74HC10; DIP-14_W7.62mm
X1: 14.31818MHz; Oscillator_DIP-14

Connections:
+5V: U2.1 (~R), U2.4 (~S), U2.14 (VCC), U3.7 (CEP), U3.9 (~PE), U3.10 (CET), U3.16 (VCC), U4.9 (~PE), U4.16 (VCC), U5.9 (~PE), U5.16 (VCC), U6.9 (~PE), U6.16 (VCC), U7.9 (~PE), U7.16 (VCC), U8.9 (~PE), U8.16 (VCC), U9.31 (PGM), U9.32 (VCC), U10.20 (VCC), U11.6 (E2), U11.16 (VCC), U12.20 (VCC), U35.14 (VCC), U45.14 (VCC), U49.13, U49.14 (VCC), X1.1 (Tri-State), X1.14 (Vcc)
BLINK: U35.11 (Q0)
CHAR_END: U4.7 (CEP), U4.10 (CET), U5.7 (CEP), U6.10 (CET), U45.2, U49.2, U49.5
DOTCLK: U2.5 (Q), U3.2 (CP), U4.2 (CP), U5.2 (CP), U6.2 (CP), U7.2 (CP), U8.2 (CP), U10.11 (CP), U12.11 (Cp)
FRAME_START: U10.15 (Q5)
FRM_Q3: U35.6 (Q3), U35.13 (CP)
GND: J3.10, U2.7 (GND), U3.3 (D0), U3.4 (D1), U3.5 (D2), U3.6 (D3), U3.8 (GND), U4.3 (D0), U4.4 (D1), U4.5 (D2), U4.6 (D3), U4.8 (GND), U5.3 (D0), U5.4 (D1), U5.5 (D2), U5.6 (D3), U5.8 (GND), U6.3 (D0), U6.4 (D1), U6.5 (D2), U6.6 (D3), U6.8 (GND), U7.3 (D0), U7.4 (D1), U7.5 (D2), U7.6 (D3), U7.8 (GND), U8.3 (D0), U8.4 (D1), U8.5 (D2), U8.6 (D3), U8.8 (GND), U9.2 (A16), U9.16 (GND), U9.22 (CE), U9.24 (OE), U10.10 (GND), U10.17 (D6), U10.18 (D7), U11.4 (~E0), U11.5 (~E1), U11.8 (GND), U12.1 (OE), U12.9 (D7), U12.10 (GND), U35.2 (MR), U35.7 (GND), U35.12 (MR), U45.7 (GND), U49.7 (GND), X1.7 (GND)
H0: U4.14 (Q0), U9.12 (A0)
H1: U4.13 (Q1), U9.11 (A1)
H2: U4.12 (Q2), U9.10 (A2)
H3: U4.11 (Q3), U9.9 (A3)
H4: J3.3, U5.14 (Q0), U9.8 (A4)
H5: J3.4, U5.13 (Q1), U9.7 (A5)
H6: J3.5, U5.12 (Q2), U9.6 (A6)
H_END: U6.7 (CEP), U7.7 (CEP), U8.7 (CEP), U10.6 (Q2), U49.1, U49.4
H_TC: U4.15 (TC), U5.10 (CET)
OSC14M: U2.3 (C), X1.8 (OUT)
P0: J3.2, U3.14 (Q0), U11.1 (A0)
P1: U3.13 (Q1), U11.2 (A1)
P2: J3.1, U3.12 (Q2), U11.3 (A2)
PH5: U45.4
ROW_CLK: U10.12 (Q4)
TROM_D0: U9.13 (D0), U10.3 (D0)
TROM_D1: U9.14 (D1), U10.4 (D1)
TROM_D2: U9.15 (D2), U10.7 (D2)
TROM_D3: U9.17 (D3), U10.8 (D3)
TROM_D4: U9.18 (D4), U10.13 (D4)
TROM_D5: U9.19 (D5), U10.14 (D5)
V0: J3.6, U6.14 (Q0), U9.5 (A7)
V1: J3.7, U6.13 (Q1), U9.27 (A8)
V2: J3.8, U6.12 (Q2), U9.26 (A9)
V3: J3.9, U6.11 (Q3), U9.23 (A10)
V4: U7.14 (Q0), U9.25 (A11)
V5: U7.13 (Q1), U9.4 (A12)
V6: U7.12 (Q2), U9.28 (A13)
V7: U7.11 (Q3), U9.29 (A14)
V8: U8.14 (Q0), U9.3 (A15)
V_END: U10.9 (Q3), U35.1 (CP), U49.3
V_TC1: U6.15 (TC), U7.10 (CET)
V_TC2: U7.15 (TC), U8.10 (CET)
~BLANK: U10.5 (Q1)
~CSYNC: U10.2 (Q0)
~DOTCLK: U2.2 (D), U2.6 (~Q)
~HCLR: U4.1 (~MR), U5.1 (~MR), U49.12
~PH3: U12.17 (Q2)
~PH5: U12.15 (Q4), U45.3
~PH6: U10.1 (~E), U12.14 (Q5), U45.1
~VCLR: U6.1 (~MR), U7.1 (~MR), U8.1 (~MR), U49.6
~Y0: U11.15 (~Y0), U12.2 (D0)
~Y1: U11.14 (~Y1), U12.3 (D1)
~Y2: U11.13 (~Y2), U12.4 (D2)
~Y3: U11.12 (~Y3), U12.5 (D3)
~Y4: U11.11 (~Y4), U12.6 (D4)
~Y5: U11.10 (~Y5), U12.7 (D5)
~Y6: U3.1 (~MR), U11.9 (~Y6), U12.8 (D6)

Notes on the sheet:
CLOCK, DOT PHASE & VIDEO TIMING
Pin numbers are DIP. Where KiCad has no HC/AC symbol the LS/HCT symbol with the
same pin-out is used; Value is the part to fit.
Every register/counter is clocked by DOTCLK and enabled by CHAR_END or /PH6;
74HC163 /CLR and /LOAD are synchronous.
Timing ROM output is registered (U10): table entries are one char early (roms.py).
J3 pin-out and refresh mapping (CL, H4-H6, V0-V3) must be verified on sheet 2/3.
CLOCK & DOT PHASE
VIDEO TIMING
