linuxha/A1Video/kicad/video.kicad_sch

## KiCad design kicad/video.kicad_sch (2026-10-29)

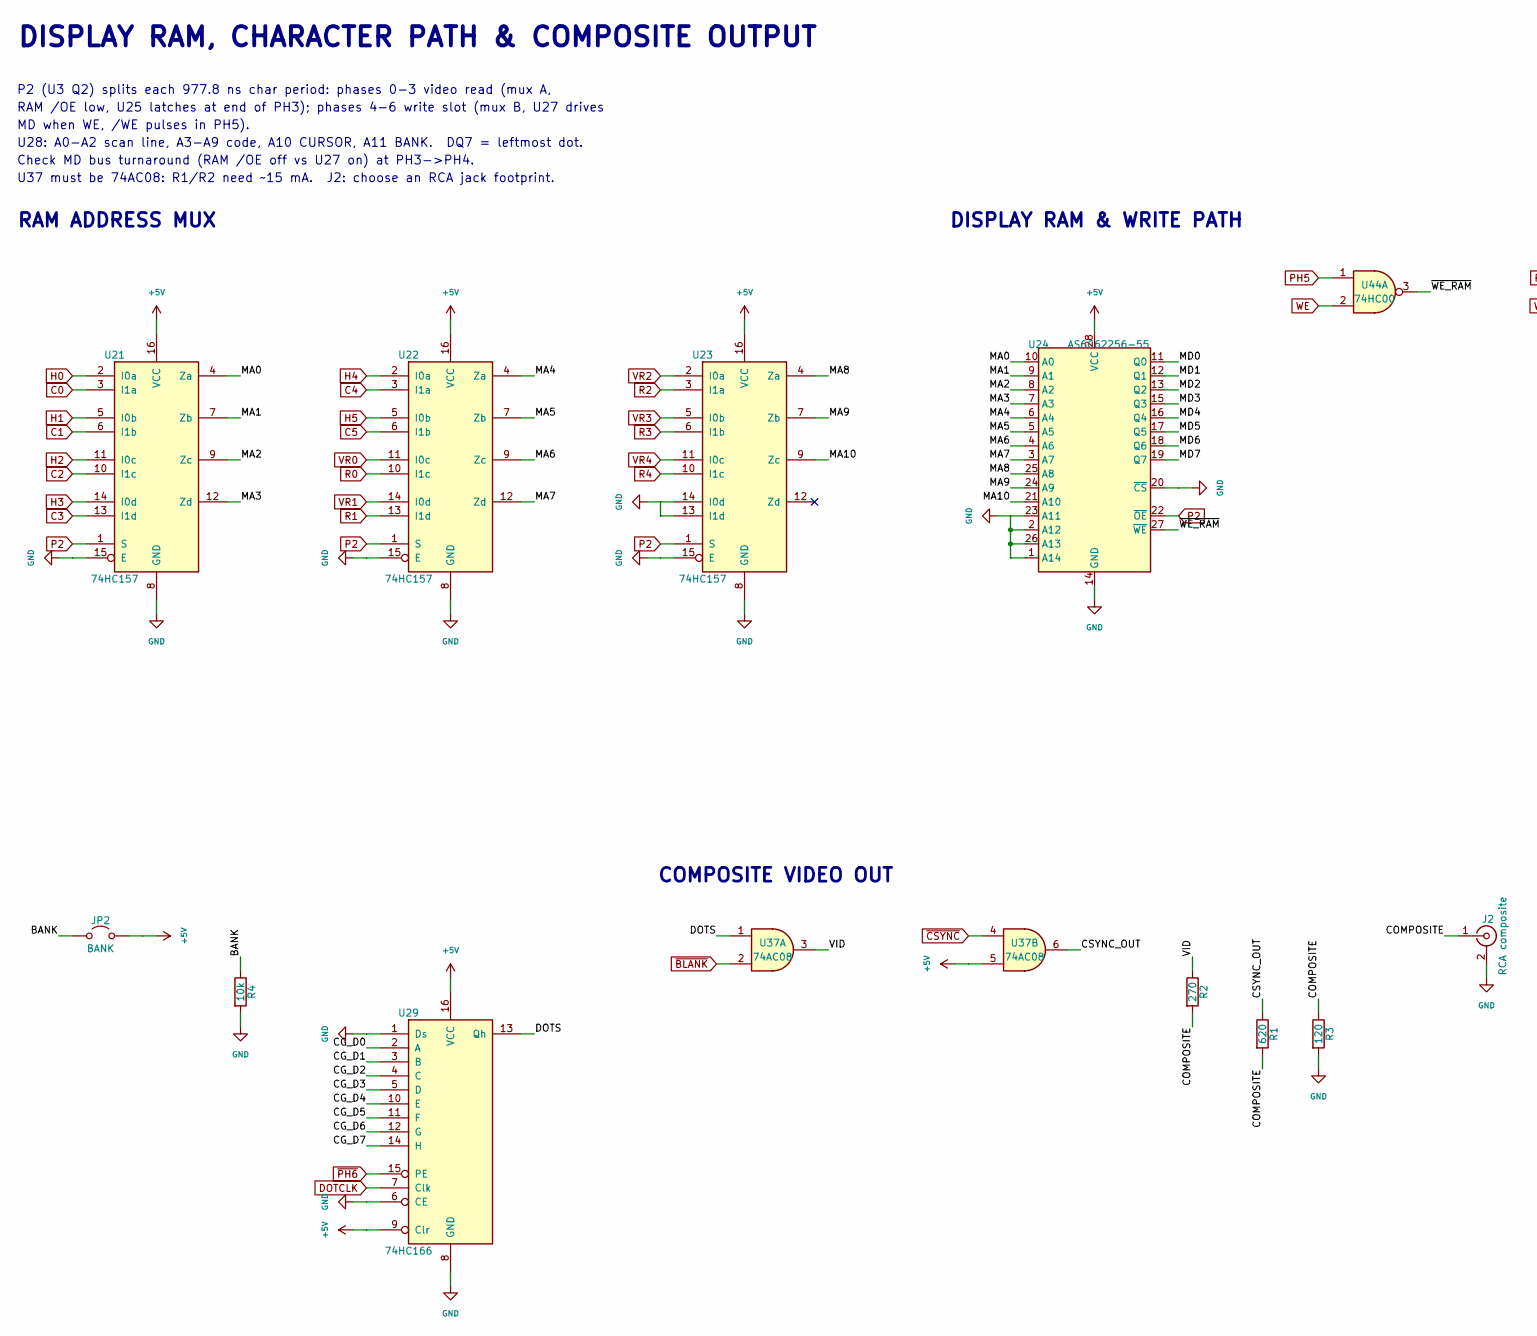
[picture p15: schematic video.kicad_sch, part in row 1, column 1]

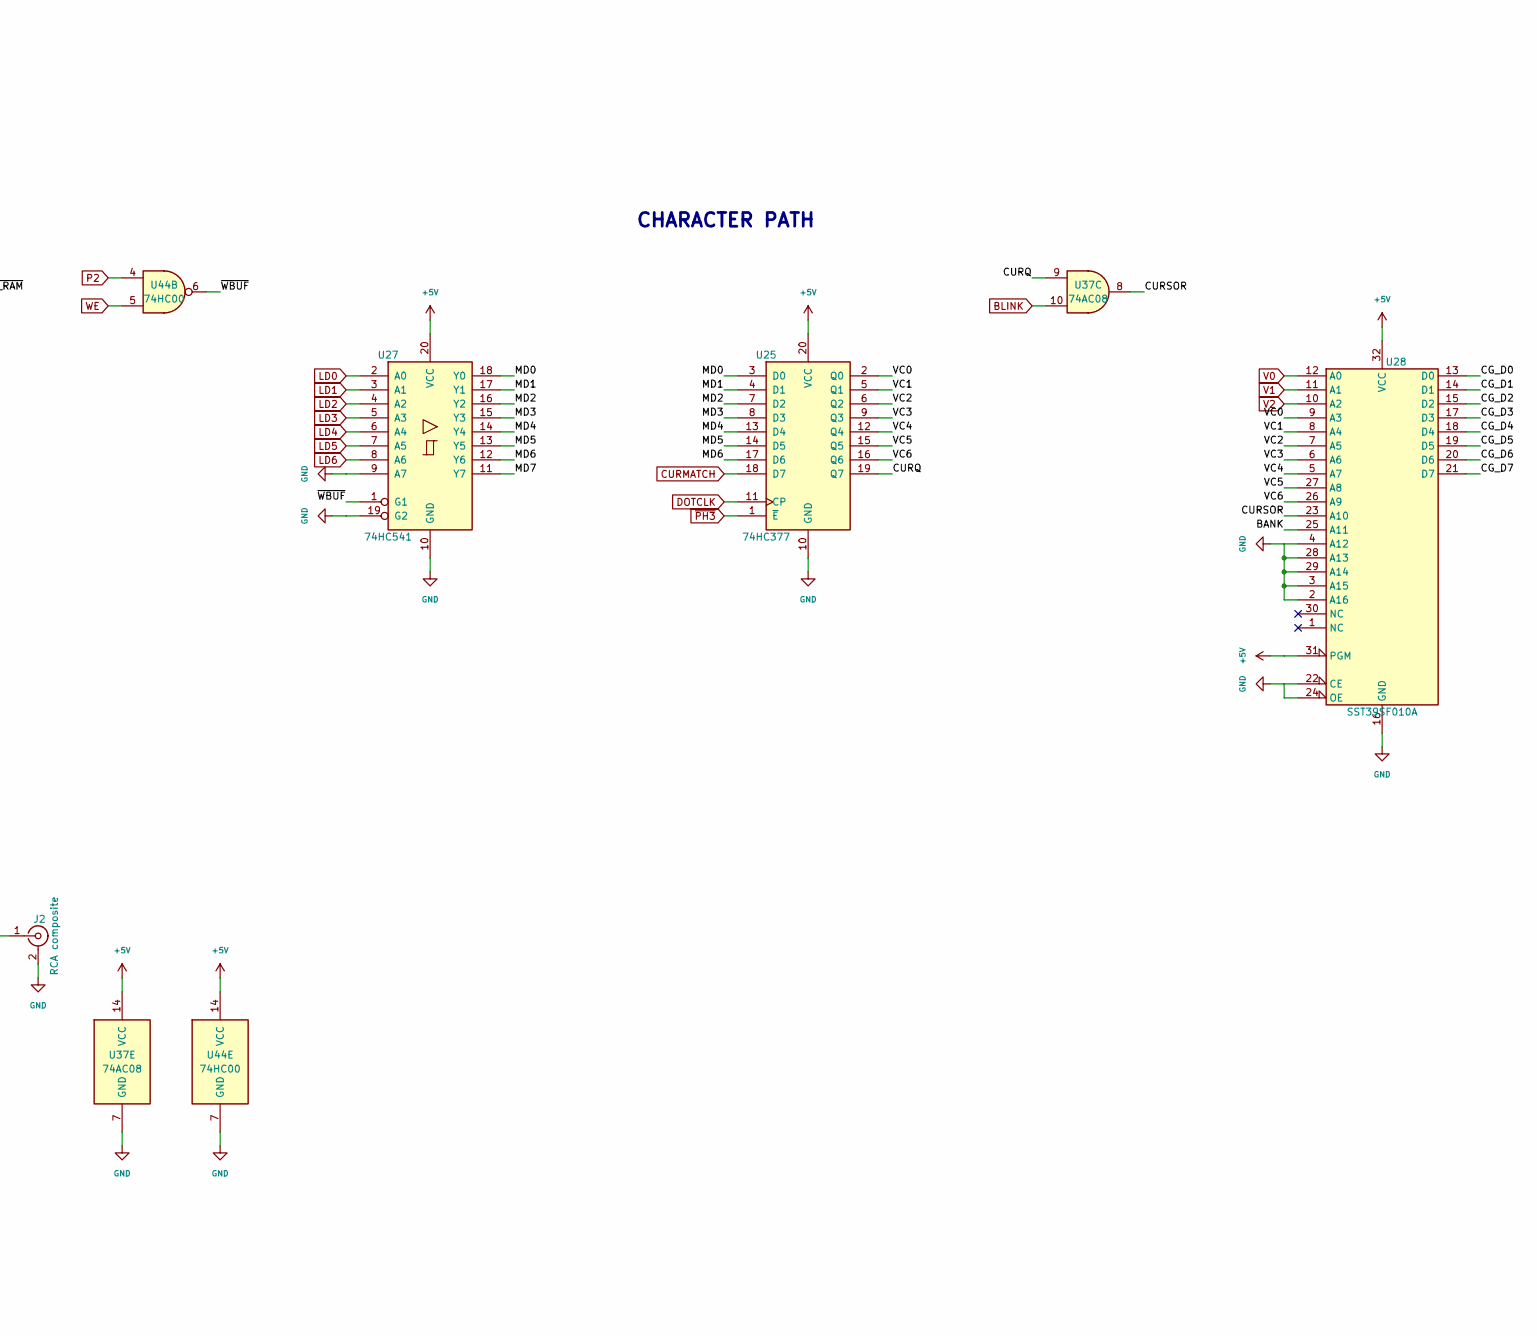
[picture p16: schematic video.kicad_sch, part in row 1, column 2]

Parts:
J2: RCA composite
JP2: BANK; PinHeader_1x02_P2.54mm_Vertical
R1: 620; R_Axial_DIN0207_L6.3mm_D2.5mm_P10.16mm_Horizontal
R2: 270; R_Axial_DIN0207_L6.3mm_D2.5mm_P10.16mm_Horizontal
R3: 120; R_Axial_DIN0207_L6.3mm_D2.5mm_P10.16mm_Horizontal
R4: 10k; R_Axial_DIN0207_L6.3mm_D2.5mm_P10.16mm_Horizontal
U21, U22, U23: 74HC157; DIP-16_W7.62mm
U24: AS6C62256-55; DIP-28_W15.24mm
U25: 74HC377; DIP-20_W7.62mm
U27: 74HC541; DIP-20_W7.62mm
U28: SST39SF010A; DIP-32_W15.24mm
U29: 74HC166; DIP-16_W7.62mm
U37: 74AC08; DIP-14_W7.62mm
U44: 74HC00; DIP-14_W7.62mm

Connections:
+5V: JP2.2 (B), U21.16 (VCC), U22.16 (VCC), U23.16 (VCC), U24.28 (VCC), U25.20 (VCC), U27.20 (VCC), U28.31 (PGM), U28.32 (VCC), U29.9 (Clr), U29.16 (VCC), U37.5, U37.14 (VCC), U44.14 (VCC)
BANK: JP2.1 (A), R4.1, U28.25 (A11)
BLINK: U37.10
C0: U21.3 (I1a)
C1: U21.6 (I1b)
C2: U21.10 (I1c)
C3: U21.13 (I1d)
C4: U22.3 (I1a)
C5: U22.6 (I1b)
CG_D0: U28.13 (D0), U29.2 (A)
CG_D1: U28.14 (D1), U29.3 (B)
CG_D2: U28.15 (D2), U29.4 (C)
CG_D3: U28.17 (D3), U29.5 (D)
CG_D4: U28.18 (D4), U29.10 (E)
CG_D5: U28.19 (D5), U29.11 (F)
CG_D6: U28.20 (D6), U29.12 (G)
CG_D7: U28.21 (D7), U29.14 (H)
COMPOSITE: J2.1 (In), R1.2, R2.2, R3.1
CSYNC_OUT: R1.1, U37.6
CURMATCH: U25.18 (D7)
CURQ: U25.19 (Q7), U37.9
CURSOR: U28.23 (A10), U37.8
DOTCLK: U25.11 (CP), U29.7 (Clk)
DOTS: U29.13 (Qh), U37.1
GND: J2.2 (Ext), R3.2, R4.2, U21.8 (GND), U21.15 (E), U22.8 (GND), U22.15 (E), U23.8 (GND), U23.13 (I1d), U23.14 (I0d), U23.15 (E), U24.1 (A14), U24.2 (A12), U24.14 (GND), U24.20 (~CS), U24.23 (A11), U24.26 (A13), U25.10 (GND), U27.9 (A7), U27.10 (GND), U27.19 (G2), U28.2 (A16), U28.3 (A15), U28.4 (A12), U28.16 (GND), U28.22 (CE), U28.24 (OE), U28.28 (A13), U28.29 (A14), U29.1 (Ds), U29.6 (CE), U29.8 (GND), U37.7 (GND), U44.7 (GND)
H0: U21.2 (I0a)
H1: U21.5 (I0b)
H2: U21.11 (I0c)
H3: U21.14 (I0d)
H4: U22.2 (I0a)
H5: U22.5 (I0b)
LD0: U27.2 (A0)
LD1: U27.3 (A1)
LD2: U27.4 (A2)
LD3: U27.5 (A3)
LD4: U27.6 (A4)
LD5: U27.7 (A5)
LD6: U27.8 (A6)
MA0: U21.4 (Za), U24.10 (A0)
MA1: U21.7 (Zb), U24.9 (A1)
MA2: U21.9 (Zc), U24.8 (A2)
MA3: U21.12 (Zd), U24.7 (A3)
MA4: U22.4 (Za), U24.6 (A4)
MA5: U22.7 (Zb), U24.5 (A5)
MA6: U22.9 (Zc), U24.4 (A6)
MA7: U22.12 (Zd), U24.3 (A7)
MA8: U23.4 (Za), U24.25 (A8)
MA9: U23.7 (Zb), U24.24 (A9)
MA10: U23.9 (Zc), U24.21 (A10)
MD0: U24.11 (Q0), U25.3 (D0), U27.18 (Y0)
MD1: U24.12 (Q1), U25.4 (D1), U27.17 (Y1)
MD2: U24.13 (Q2), U25.7 (D2), U27.16 (Y2)
MD3: U24.15 (Q3), U25.8 (D3), U27.15 (Y3)
MD4: U24.16 (Q4), U25.13 (D4), U27.14 (Y4)
MD5: U24.17 (Q5), U25.14 (D5), U27.13 (Y5)
MD6: U24.18 (Q6), U25.17 (D6), U27.12 (Y6)
MD7: U24.19 (Q7), U27.11 (Y7)
P2: U21.1 (S), U22.1 (S), U23.1 (S), U24.22 (~OE), U44.4
PH5: U44.1
R0: U22.10 (I1c)
R1: U22.13 (I1d)
R2: U23.3 (I1a)
R3: U23.6 (I1b)
R4: U23.10 (I1c)
V0: U28.12 (A0)
V1: U28.11 (A1)
V2: U28.10 (A2)
VC0: U25.2 (Q0), U28.9 (A3)
VC1: U25.5 (Q1), U28.8 (A4)
VC2: U25.6 (Q2), U28.7 (A5)
VC3: U25.9 (Q3), U28.6 (A6)
VC4: U25.12 (Q4), U28.5 (A7)
VC5: U25.15 (Q5), U28.27 (A8)
VC6: U25.16 (Q6), U28.26 (A9)
VID: R2.1, U37.3
VR0: U22.11 (I0c)
VR1: U22.14 (I0d)
VR2: U23.2 (I0a)
VR3: U23.5 (I0b)
VR4: U23.11 (I0c)
WE: U44.2, U44.5
~BLANK: U37.2
~CSYNC: U37.4
~PH3: U25.1 (~E)
~PH6: U29.15 (PE)
~WBUF: U27.1 (G1), U44.6
~WE_RAM: U24.27 (~WE), U44.3

Notes on the sheet:
DISPLAY RAM, CHARACTER PATH & COMPOSITE OUTPUT
P2 (U3 Q2) splits each 977.8 ns char period: phases 0-3 video read (mux A,
RAM /OE low, U25 latches at end of PH3); phases 4-6 write slot (mux B, U27 drives
MD when WE, /WE pulses in PH5).
U28: A0-A2 scan line, A3-A9 code, A10 CURSOR, A11 BANK. DQ7 = leftmost dot.
Check MD bus turnaround (RAM /OE off vs U27 on) at PH3->PH4.
U37 must be 74AC08: R1/R2 need ~15 mA. J2: choose an RCA jack footprint.
RAM ADDRESS MUX
DISPLAY RAM & WRITE PATH
CHARACTER PATH
COMPOSITE VIDEO OUT
