linuxha/A1Video/(commit log)

2026-10-29 Add NTSC redesign document for the terminal section
    Design for replacing the Apple-1 terminal section (00101 sheet 1/3) with
    current-production 5V logic and NTSC composite output:
    - analysis of the original PMOS shift-register design
    - 14.31818 MHz clock, 7.159 MHz dot clock, 1.0227 MHz CLA
    - 65x262 progressive timing from a registered timing ROM
    - SRAM display memory with time-sliced video/write access
    - hardware scroll via TOP/VROW counters
    - ROM-based Moore-machine control sequencer
    - resistor DAC composite output
    - open items to verify on hardware
2026-10-29 Add block-level and gate-level schematic drawings
    - docs/a1video-schematic.{png,svg}: one-page block schematic (schematic.py)
    - docs/schematic/a1video-sheet1..4.{png,svg}: gate-level sheets with DIP
    pin numbers, wiring, buses and off-sheet connectors (gateschem.py)
    Pin numbers are hand-entered and must be checked against datasheets.
2026-10-29 Add generated KiCad 9 project
    a1video/kicad.py holds the design as a pin-by-pin netlist transcribed
    from the gate-level sheets, and generates kicad/: a root sheet plus
    Timing, Video, Sequencer, Counters and Power/decoupling sheets.
    - symbols: stock KiCad library symbols; where there is no HC/AC symbol,
    the LS/HCT symbol with the same DIP pin-out is used
    - connections: pins connect through local/global net labels
    - footprints: assigned to every part except J2 (RCA jack)
    - decoupling: one 100 nF cap per IC plus a 10 uF bulk cap
    --check exports the netlist with kicad-cli, compares it pin for pin with
    the table, and runs ERC. Both pass: 0 differences, 0 violations.
    python3 -m a1video.ki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
    [a1video.kicad_sch, counters.kicad_sch, power.kicad_sch, sequencer.kicad_sch, timing.kicad_sch, video.kicad_sch]
